BME-SBT/ESP32_CAN_V2/README.md

# ESP32_CAN_V2
New version of the ESP32-C6_CANboard repo
(Upgraded version of the ESP32_CAN_V1)
