BME-SBT/ESP32_CAN_V2/documentation/content/alkatreszlista.tex

\begin{landscape}
	\section{Alkatrész rendelési lista}
	\begin{center}
		\begin{longtable}{@{} p{6cm} p{5cm} p{10cm} p{2cm} @{}}
			\caption{CAN\_V1 alkatrészlista}\\
			\toprule
			Mfr. No & Manufacturer & Description & Order Qty. \\
			\midrule
			\endfirsthead
			
			\multicolumn{4}{c}{\textit{Folytatás az előző oldalról}}\\
			\toprule
			Mfr. No & Manufacturer & Description & Order Qty. \\
			\midrule
			\endhead
			
			\midrule
			\multicolumn{4}{r}{\textit{Folytatás a következő oldalon}}\\
			\endfoot
			
			\bottomrule
			\endlastfoot
			
			CL10B104KA8NFNC & Samsung Electro-Mechanics & Multilayer Ceramic Capacitors MLCC - SMD/SMT 100nF+/-10\% 25V X7R 0603 & 120 \\
			MBASG168AB7105KTNA01 & TAIYO YUDEN & Multilayer Ceramic Capacitors MLCC - SMD/SMT 35V 1uF X7R 0603 10\% & 15 \\
			06035C202JAT2A & KYOCERA AVX & Multilayer Ceramic Capacitors MLCC - SMD/SMT 50V 2000pF X7R 0603 5\% & 15 \\
			CL10B102KB85PNC & Samsung Electro-Mechanics & Multilayer Ceramic Capacitors MLCC - SMD/SMT 1nF+/-10\% 50V X7R 0603 & 15 \\
			EMK212BB7106KG-T & TAIYO YUDEN & Multilayer Ceramic Capacitors MLCC - SMD/SMT 16V 10uF X7R 0805 10\% & 60 \\
			CL21A226MAYNNNE & Samsung Electro-Mechanics & Multilayer Ceramic Capacitors MLCC - SMD/SMT 22uF+/-20\% 25V X5R 0805 & 50 \\
			CL21B225KPFNNNG & Samsung Electro-Mechanics & Multilayer Ceramic Capacitors MLCC - SMD/SMT 2.2uF+/-10\% 10V X7R 0805 & 15 \\
			CL10C470JC8NNNC & Samsung Electro-Mechanics & Multilayer Ceramic Capacitors MLCC - SMD/SMT 47pF+/-5\% 100V C0G 0603 & 40 \\
			AMK316ABJ107ML-T & TAIYO YUDEN & Multilayer Ceramic Capacitors MLCC - SMD/SMT 100uF X5R 1206 20\% & 15 \\
			WR06X1003FTL & Walsin & Thick Film Resistors - SMD 100K ohms 1\% 0603 & 40 \\
			CRCW060310K0JNEA & Vishay & Thick Film Resistors - SMD 1/8 Watt 10Kohms 5\% & 30 \\
			AC0603JR-07120RL & YAGEO & Thick Film Resistors - SMD 120 Ohms 1/10 W 75 V 5\% 0603 AEC-Q200 & 30 \\
			RC0603FR-101KL & YAGEO & Thick Film Resistors - SMD General Purpose Chip Resistor 0603, 1kOhms, 1\%, 1/10W & 30 \\
			CR0603-FX-5101ELF & Bourns & Thick Film Resistors - SMD 5.1K ohm 1\% & 30 \\
			RC0603FR-133K3L & YAGEO & Thick Film Resistors - SMD General Purpose Chip Resistor 0603, 3.3kOhms, 1\%, 1/10W & 15 \\
			CR0603-FX-3240ELF & Bourns & Thick Film Resistors - SMD 324 ohm 1\% & 15 \\
			CR0603-FX-3162ELF & Bourns & Thick Film Resistors - SMD 31.6K ohm 1\% & 15 \\
			RC0603JR-13470RL & YAGEO & Thick Film Resistors - SMD General Purpose Chip Resistor 0603, 470Ohms, 5\%, 1/10W & 15 \\
			RC0603FR-0764K9P & YAGEO & Thick Film Resistors - SMD General Purpose Chip Resistor 0603, 64.9kOhms, 1\%, 1/10W & 15 \\
			CR0603-FX-3092ELF & Bourns & Thick Film Resistors - SMD 30.9KOHM 1/10WATT 1\% & 15 \\
			RC0603FR-07154KL & YAGEO & Thick Film Resistors - SMD General Purpose Chip Resistor 0603, 154kOhms, 1\%, 1/10W & 15 \\
			AC0603FR-0713K7L & YAGEO & Thick Film Resistors - SMD 13.7 kOhms 1/10 W 75 V 1\% 0603 AEC-Q200 & 15 \\
			USBLC6-2SC6 & STMicroelectronics & ESD Protection Diodes / TVS Diodes ESD Protection Low Cap & 15 \\
			150060YS83000 & Wurth Elektronik & Single Colour LEDs WL-SMCW SMT 0603 Dome Yellow Typ 650mcd 2V & 15 \\
			150060AS83000 & Wurth Elektronik & Single Colour LEDs WL-SMCW SMT 0603 Dome Amber Typ 500mcd 2V & 15 \\
			150060RS83000 & Wurth Elektronik & Single Colour LEDs WL-SMCW SMT 0603 Dome Red Typ 1800mcd 2V & 15 \\
			150060VS83000 & Wurth Elektronik & Single Colour LEDs WL-SMCW SMT 0603 Dome Bright Green Typ 300mcd 2V & 15 \\
			150060BS83000 & Wurth Elektronik & Single Colour LEDs WL-SMCW SMT 0603 Dome Blue Typ 1500mcd 3.2V & 15 \\
			10129381-908002BLF & Amphenol & Headers \& Wire Housings ECONOSTIK HEADER DR VT TH 2X4 & 12 \\
			10129381-924003BLF & Amphenol & Headers \& Wire Housings ECONOSTIK HEADER DR VT TH 2X12 & 12 \\
			10129381-906003BLF & Amphenol & Headers \& Wire Housings ECONOSTIK HEADER DR VT TH 2X3 & 12 \\
			TBC05-03-1-G-G & GCT & Fixed Terminal Blocks 3w, 2.54mm Pitch Term-Block, Side Entry, TH, Rising Clamp & 2 \\
			TPS25921ADR & Texas Instruments & Hot Swap Voltage Controllers eFuse Mux OR A TPS25921AD & 11 \\
			LMR51430YDDCR & Texas Instruments & Switching Voltage Regulators SIMPLE SWITCHER 4.5-V to 36-V 3-A & 11 \\
			AP62250WU-7 & Diodes Incorporated & Switching Voltage Regulators DCDC Conv HV Buck TSOT26 3K & 12 \\
			1N5819HW-7-F & Diodes Incorporated & Schottky Diodes \& Rectifiers Vr/40V Io/1A T/R & 11 \\
			USB4105-GF-A & GCT & USB Connectors USB Type C,2.0, Rec,SMT, 0.95mmTH Shell Stakes,G/F,RA,Top Mnt,T\&R & 15 \\
			TBC05-04-1-G-G & GCT & Fixed Terminal Blocks 4w, 2.54mm Pitch Term-Block, Side Entry, TH, Rising Clamp & 2 \\
			TBC05-06-1-G-G & GCT & Fixed Terminal Blocks 6w, 2.54mm Pitch Term-Block, Side Entry, TH, Rising Clamp & 8 \\
			71966-308LF & Amphenol & Headers \& Wire Housings DUBOX RCP DR TMT VERT-POLARIZED & 2 \\
			76314-203LF & Amphenol & Headers \& Wire Housings PV & 2 \\
			76314-204LF & Amphenol & Headers \& Wire Housings PV & 2 \\
			PTSAHT120624V050 & Eaton & Resettable Fuses - PPTC PTSAHT1206 0.5A, 24V & 85 \\
			TS02-66-70-BK-260-SCR-D & Same Sky & Tactile Switches 6 x 6 mm, 7 mm Act Height, 260 gf, Black, Short Crimped, Through Hole, SPST, & 25 \\
			SMAJ30A & Littelfuse & ESD Protection Diodes / TVS Diodes 400W 30V 5\% Uni-Directional & 25 \\
			NUP2105L & Diotec Semiconductor & ESD Protection Diodes / TVS Diodes ESD Diode, SOT-23, 150C, 350W, Unidir & 15 \\
			R05CTE05S-R & RECOM & DC/DC Converters - SMD 1W 4.5-5.5Vin 5.0Vout 200mA Reel & 11 \\
			ISO6721FQDWVRQ1 & Texas Instruments & Digital Isolators Automotive general-purpose dual-channel & 11 \\
			TCAN1051HGDR & Texas Instruments & CAN Interface IC Fault Protected CAN Transceiver & 11 \\
			ESP32-C6-WROOM-1-N4 & Espressif & Multiprotocol Modules 4 MB (Quad SPI), 32-bit RISC-V Embedded Module & 11 \\
			ULN2003ADR & Texas Instruments & Darlington Transistors ULN2003 & 11 \\
			74HC595D & Toshiba & Counter Shift Registers CMOS LOGIC IC SERIES & 11 \\
			SMAJ58CA & Littelfuse & ESD Protection Diodes / TVS Diodes 400W 58V 5\% Bi-Directional & 15 \\
			AMPLA5030S-6R8MT & ABRACON & Power Inductors - SMD & 11 \\
			LCENA2520MKT2R2M0NK & TAIYO YUDEN & Power Inductors - SMD 2.2 UH 20\% & 11 \\
			
		\end{longtable}
	\end{center}
\end{landscape}
