BME-SBT/ESP32_CAN_V2/documentation/includes/cimoldal.tex

%\hypersetup{pageanchor=false}

%--------------------------------------------------------------------------------------
%	Címoldal [Title page]
%--------------------------------------------------------------------------------------
\begin{titlepage}
	\begin{center}
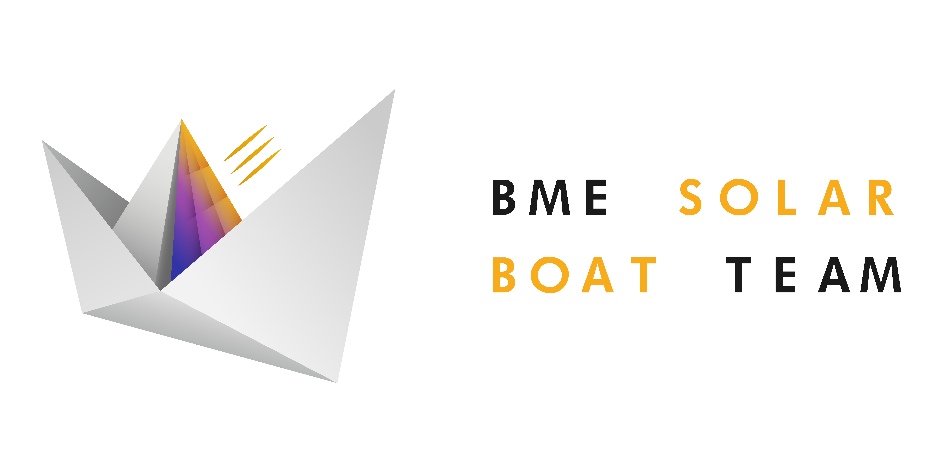
[picture p7: documentation/includes/BME-SolarBoat-logo.png]
		\\
		
		\vspace{4cm}
		
		{\Huge \MakeUppercase{\title}}\\
		\vspace{0.8cm}
		{\LARGE \subtitle}
		
		%\vspace{2cm}
		\vfill
		
		{\large \textit{
			\iflanguage{hungarian}{
				%Szerző:
			}{
				Author:
			}
		}}
		%\vspace{0.3cm}
		
		{\large
			\authorA
			
			\authorB
			
			\authorC
			
			\authorD
		}
		
		\vfill
		{\large Budapest , \today}
	\end{center}
\end{titlepage}
