BME-SBT/ESP32_CAN_V2/hardware/MessageListReport.html

Altium customize

# Message List

Date: | | 19/02/2026
Time: | | 23:58:55
Elapsed Time: | | 00:00:00

Class | Document | Source | Message | Time | Date | No.
[Warning] | ESP32_CAN_V2-can.SchDoc | Compiler | Footprint of component Component SJ1 Solderj Jumper cannot be found | 23:58:21 | 19/02/2026 | 1
[Warning] | ESP32_CAN_V2-main.SchDoc | Compiler | Nets Wire GND_CAN has multiple names (Net Label GND_CAN (6), Sheet Entry U_ESP32_CAN_V2-can-CAN_GND(Passive)) | 23:58:21 | 19/02/2026 | 2
[Info] | ESP32_CAN_V2.PrjPcb | Compiler | Compile successful, no errors found. | 23:58:21 | 19/02/2026 | 3

Back to top
