BME-SBT/ESP32_CAN_V2/documentation/pinouts.pdf

MCU ports: | Note:
GPIO_0 GPIO_1 GPIO_2 GPIO_3 GPIO_4 GPIO_5 GPIO_6 GPIO_7 GPIO_8 GPIO_9 GPIO_10 GPIO_11 GPIO_12 GPIO_13 GPIO_14 GPIO_15 | IO1 IO0 IO7 IO6 IO5 IO4 IO16 IO9 General Purpose IO18 Input/Ouput ports IO19 IO20 IO21 IO22 IO23 IO15 IO17
COM OUT_0 OUT_1 OUT_2 OUT_3 OUT_4 OUT_5 OUT_6 | This must be connected with the supply voltage of the driven devices. Shiftreg: IO8, IO10, IO11 Darlington Transistor Array with 500mA collector current capability
BUS_0 BUS_1 BUS_2 BUS_3 BUS_4 BUS_5 BUS_6 BUS_7 | Extra wires in the CAT6 cable to be able to Does not connects to connect boards with a the mcu. redundant line it it is needed.
