BME-SBT/ESP32_CAN_V2/documentation/pinouts.xlsx

 | MCU ports: | Note:
GPIO_0 | IO1 | General Purpose Input/Ouput ports
GPIO_1 | IO0
GPIO_2 | IO7
GPIO_3 | IO6
GPIO_4 | IO5
GPIO_5 | IO4
GPIO_6 | IO16
GPIO_7 | IO9
GPIO_8 | IO18
GPIO_9 | IO19
GPIO_10 | IO20
GPIO_11 | IO21
GPIO_12 | IO22
GPIO_13 | IO23
GPIO_14 | IO15
GPIO_15 | IO17
COM | Shiftreg: IO8, IO10, IO11 | This must be connected with the supply voltage of the driven devices.
OUT_0 |  | Darlington Transistor Array with 500mA collector current capability
OUT_1
OUT_2
OUT_3
OUT_4
OUT_5
OUT_6
BUS_0 | Does not connects to the mcu. | Extra wires in the CAT6 cable to be able to connect boards with a redundant line it it is needed.
BUS_1
BUS_2
BUS_3
BUS_4
BUS_5
BUS_6
BUS_7
