BME-SBT/ESP32_CAN_V2/documentation/ppt/CAN Hardware.pptx

## CAN Hardware

Fináczy Balázs

## CAN-bus

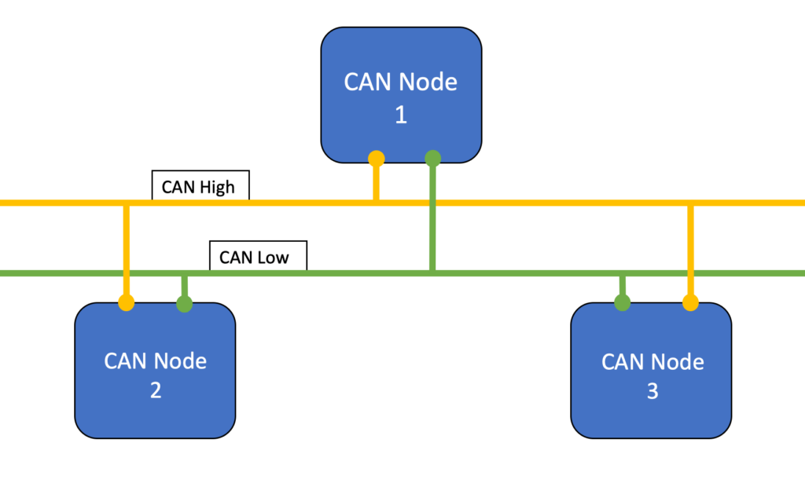
[picture p10: figure]

## Rendszerterv

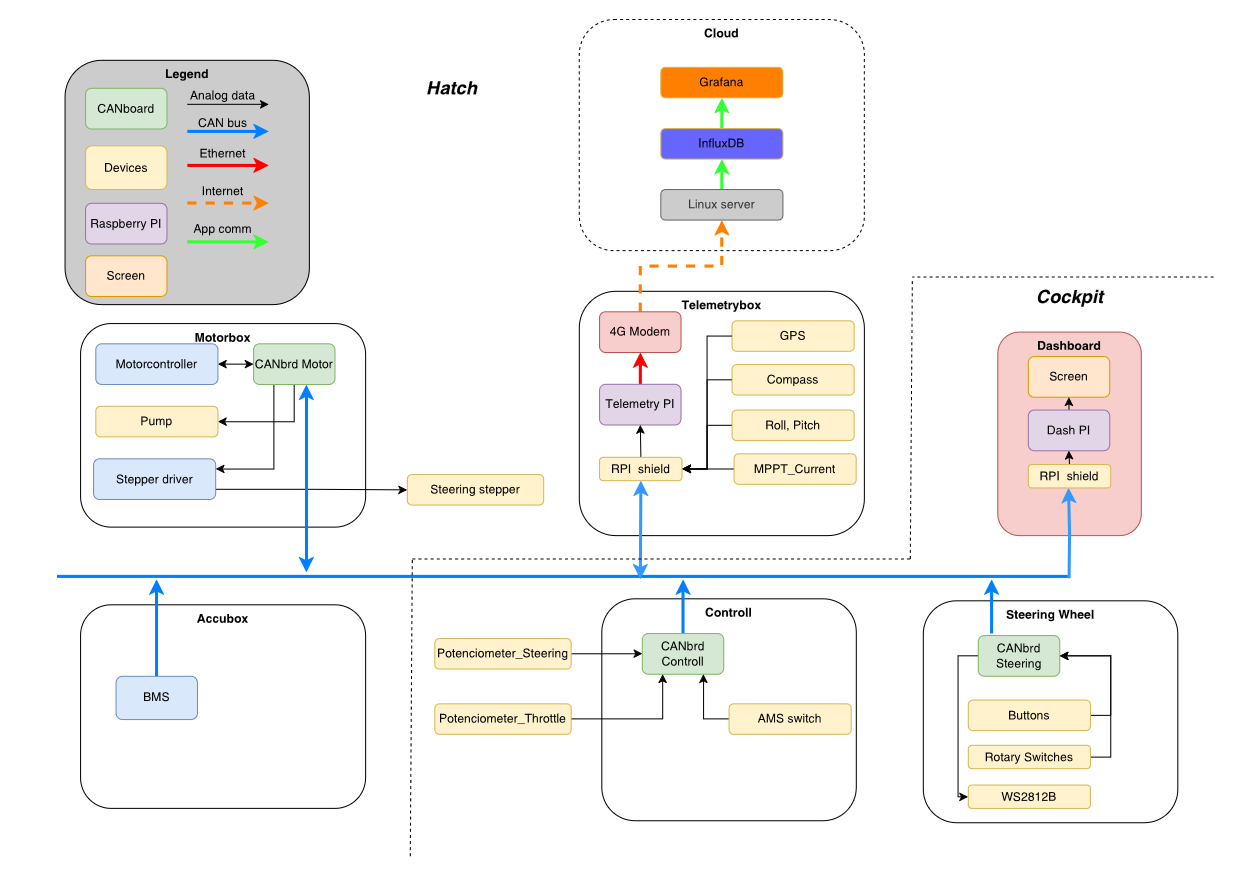
[picture p11: figure]

## Slide 4

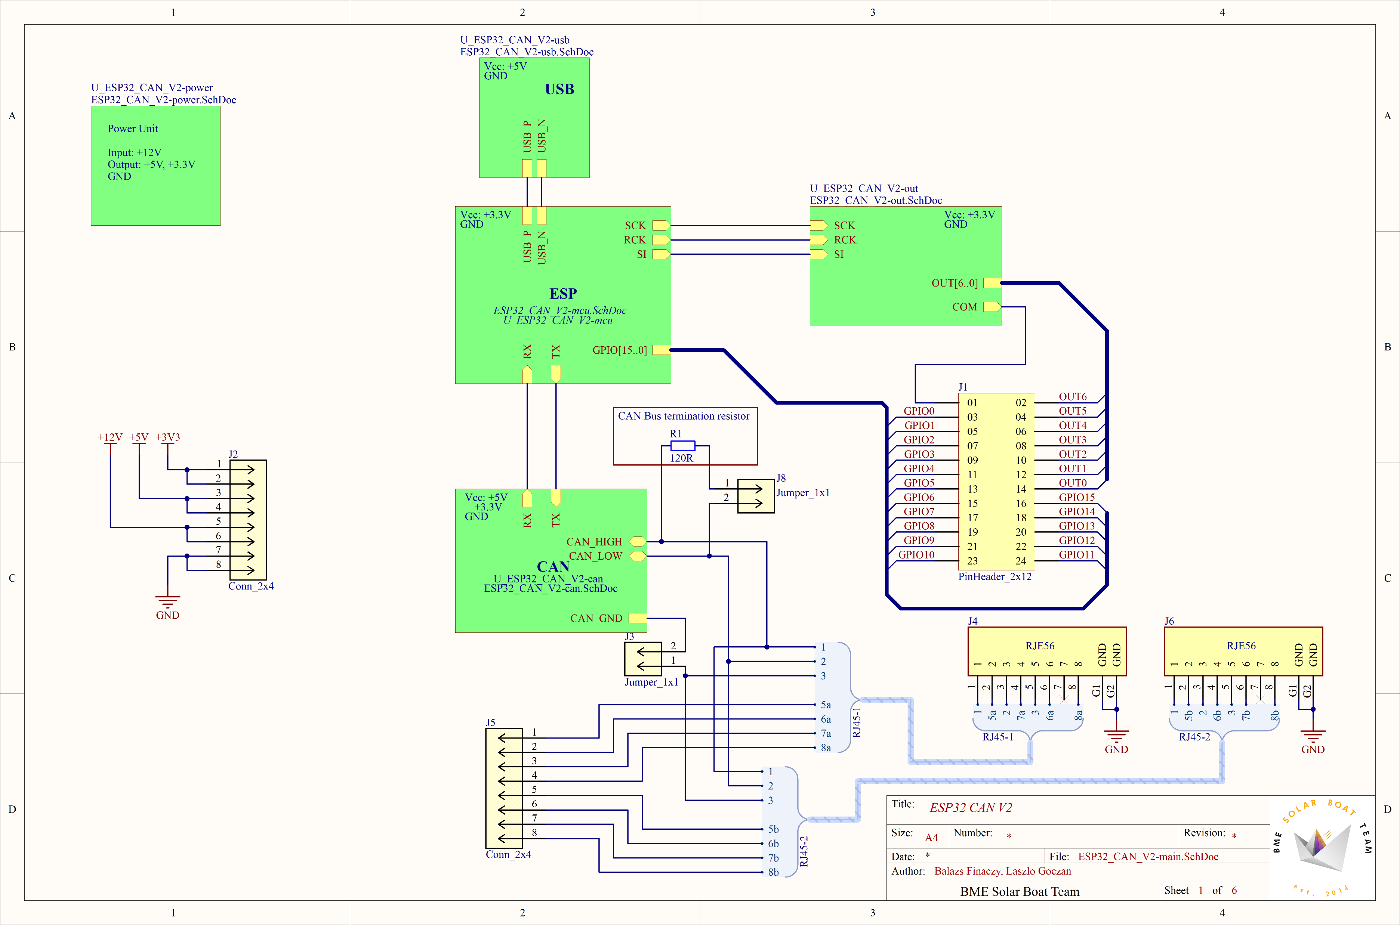
[picture p12: figure]

## Slide 5

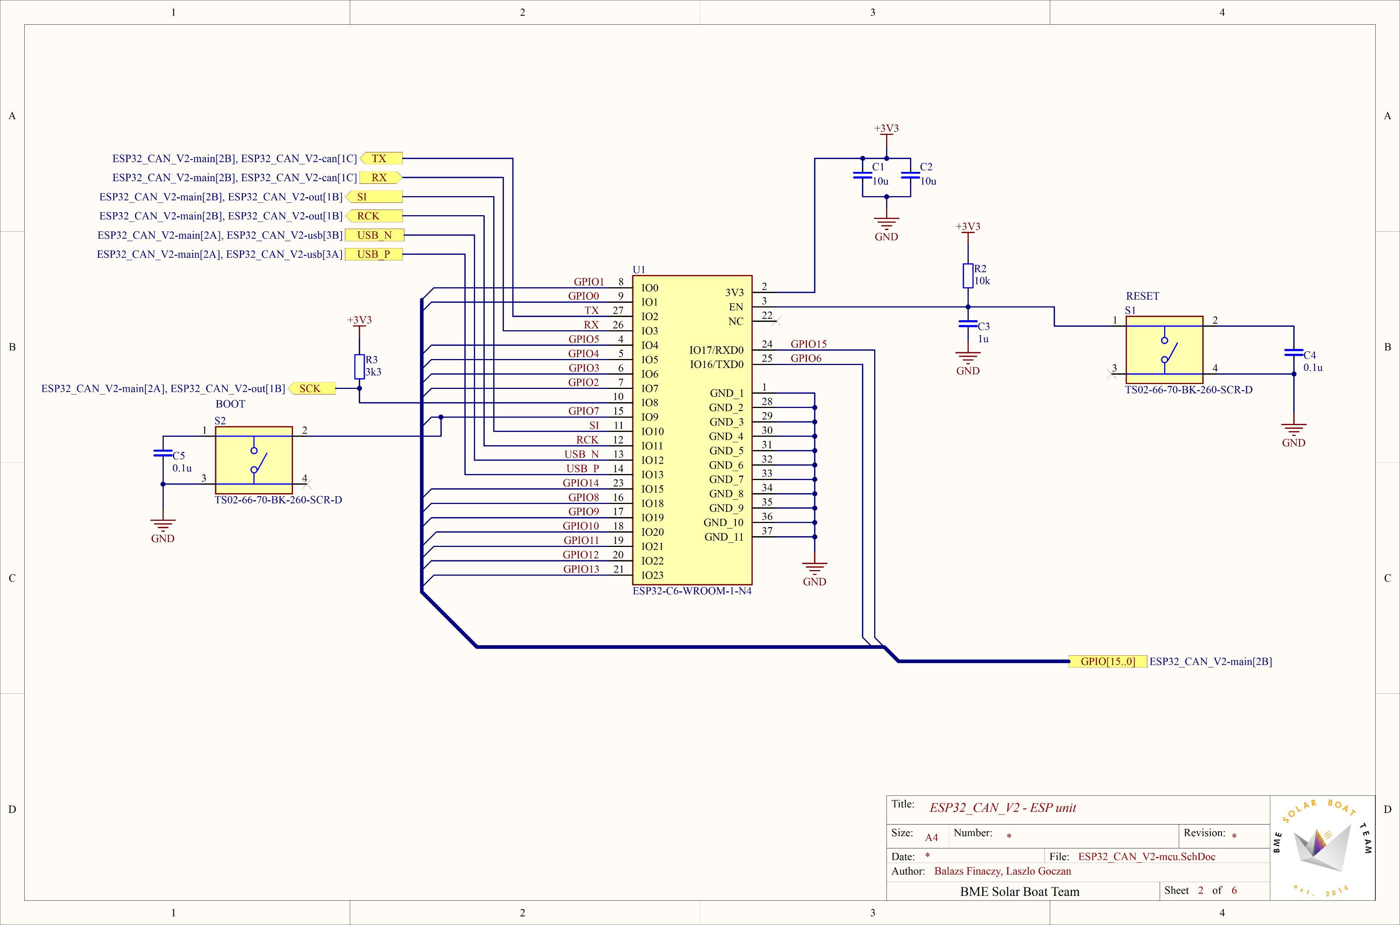
[picture p13: figure]

## Slide 6

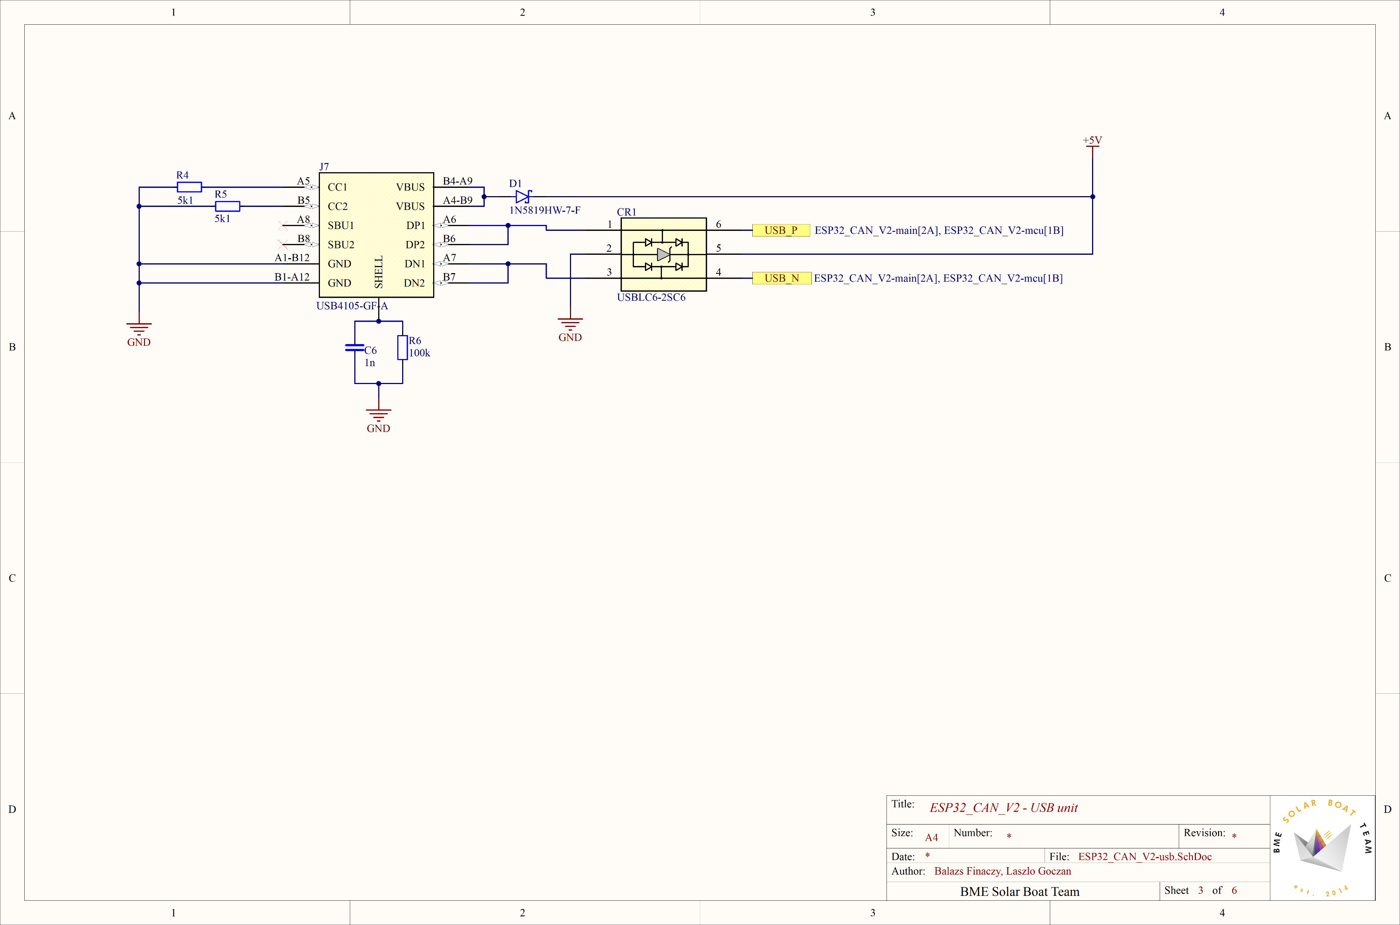
[picture p14: figure]

## Slide 7

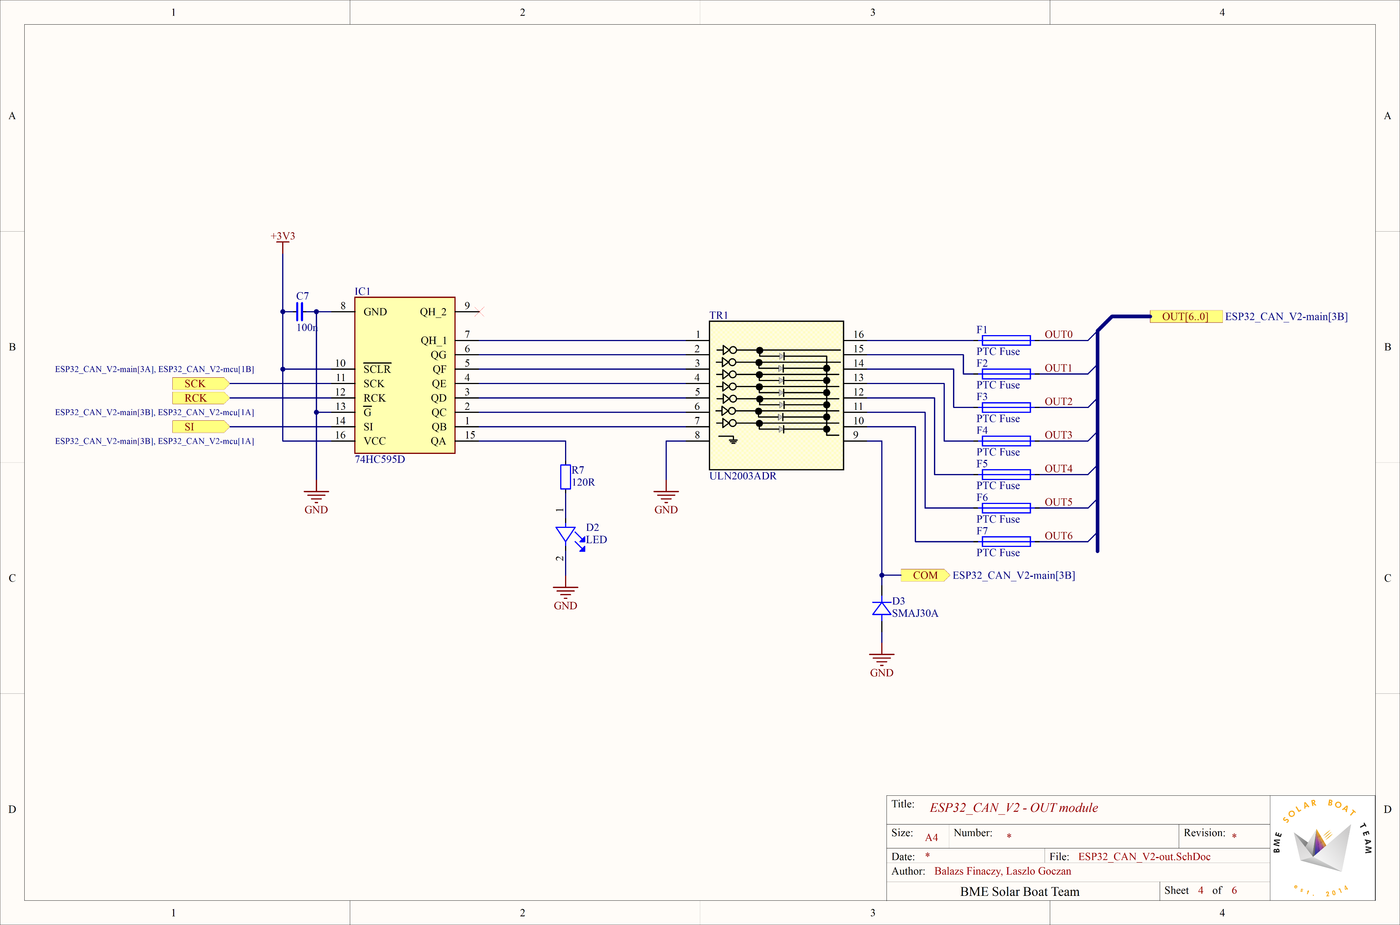
[picture p15: figure]

## Slide 8

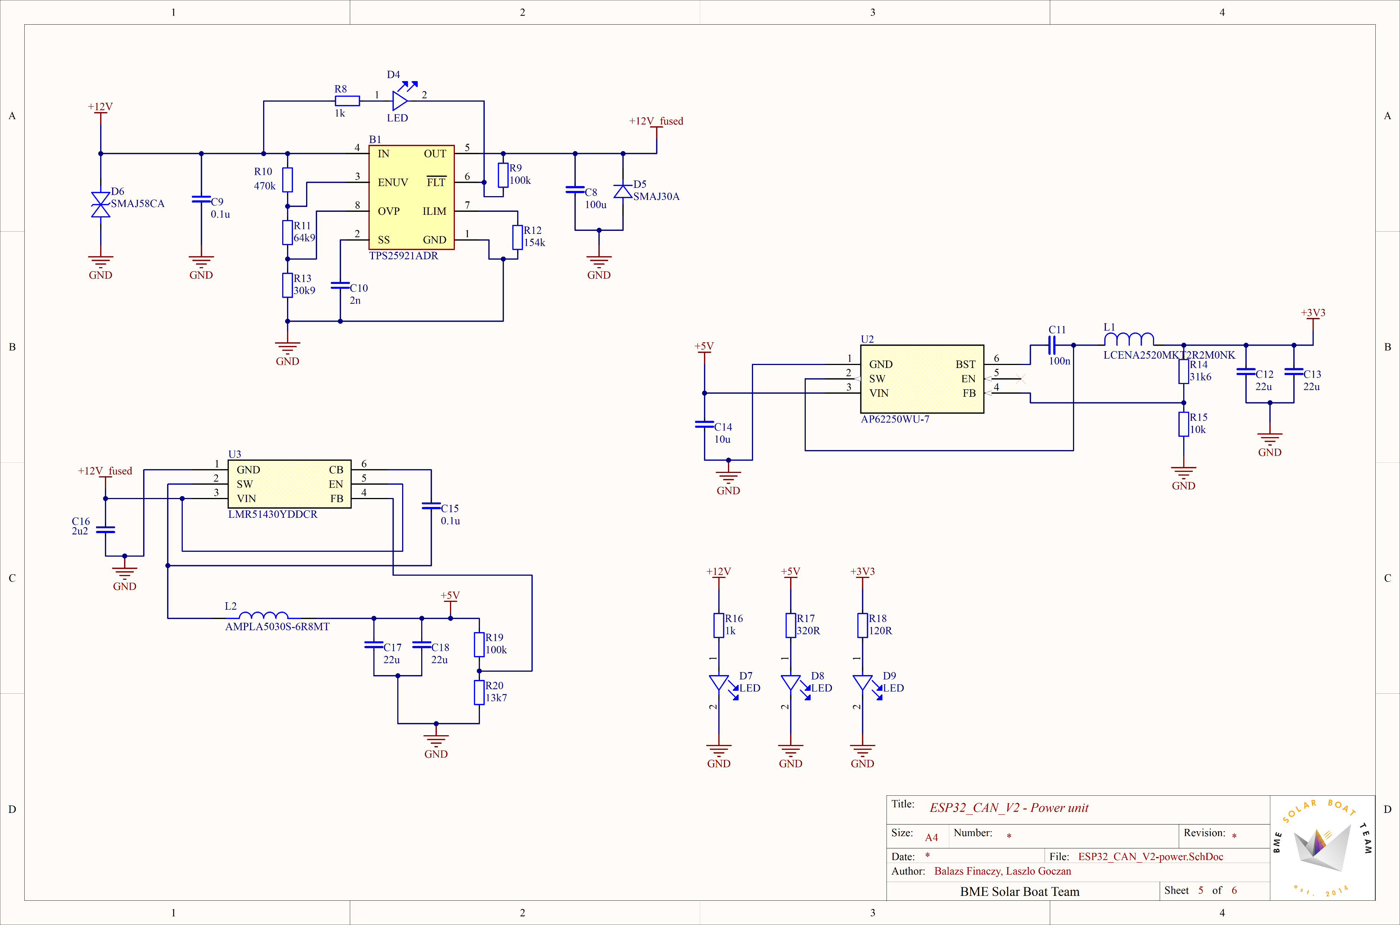
[picture p16: figure]

## Slide 9


## Slide 10

## Slide 11

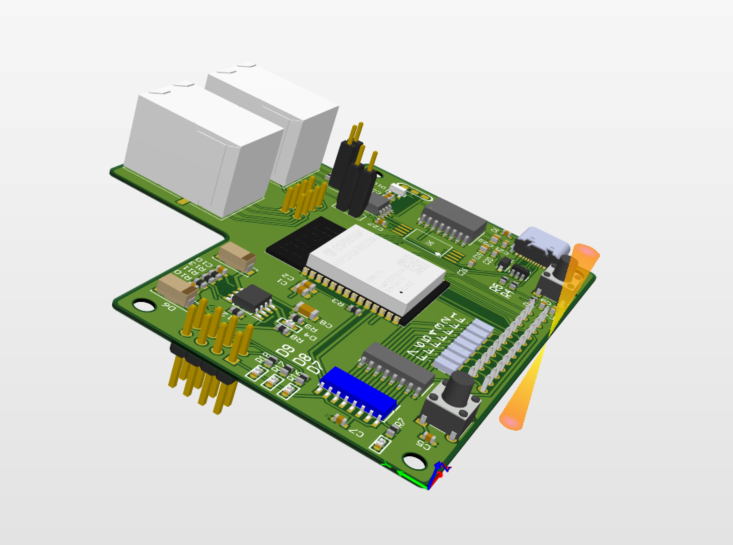
[picture p17: figure]

## Slide 12

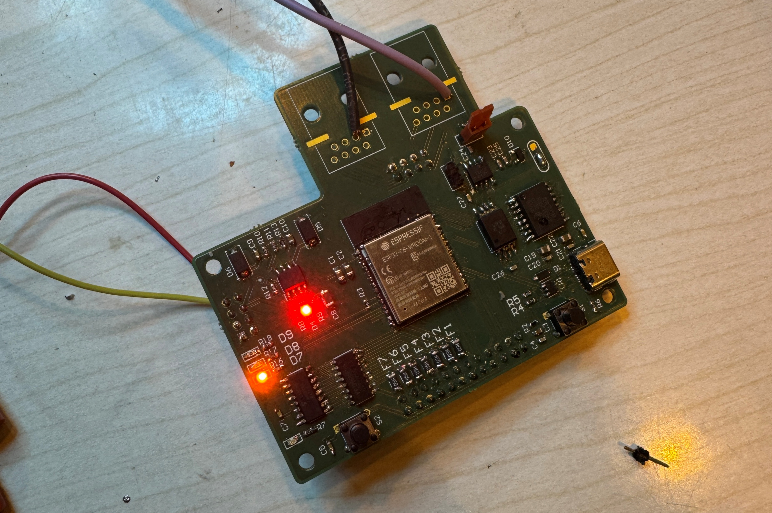
[picture p18: figure]

## Köszönöm a figyelmet!
