BME-SBT/ESP32_CAN_V2/hardware/board_outline_v2.dxf

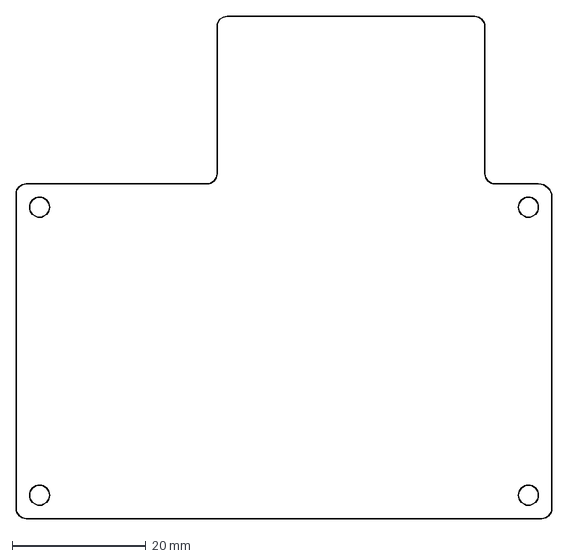
[picture p21: CAD file, 2026-06-18]
hardware/board_outline_v2.dxf
80.0 x 75.0 mm
