BME-SBT/ESP32_CAN_V2/hardware/ESP32_CAN_V2.pdf

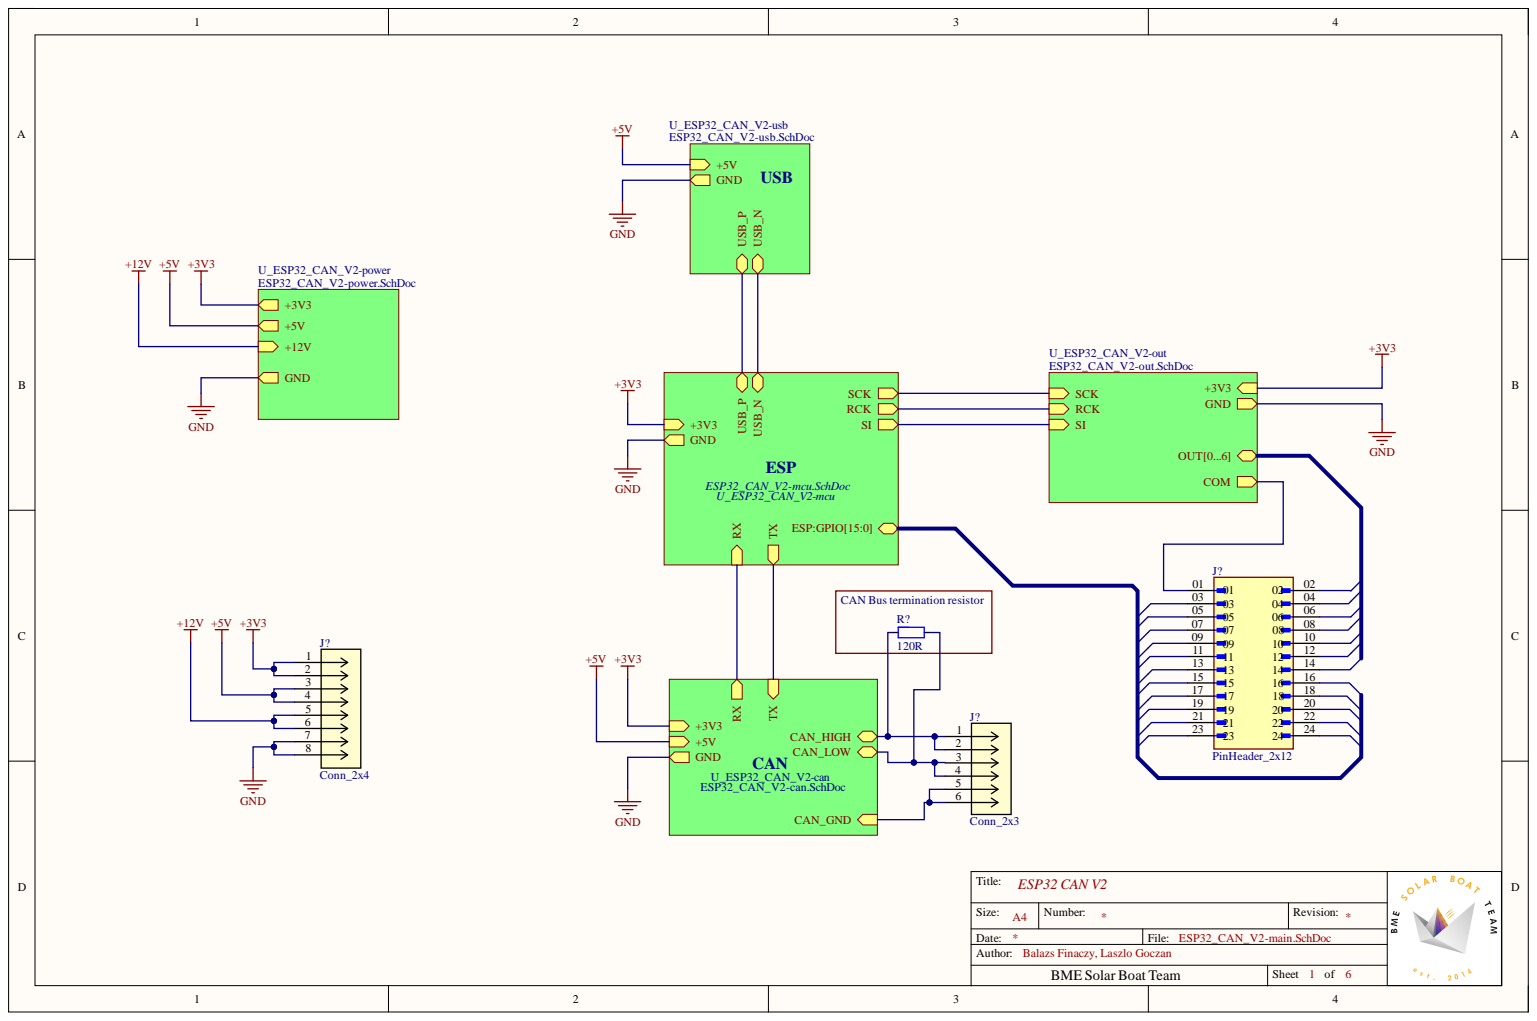
[picture p22: page 1]

T i t l e : ESP3 2 CAN V2

Size : A 4 | N umb er : * | Rev i s i o n : *

Dat e : * | Fi l e : ESP3 2 _CA N _ V 2-mai n . S c h D o c

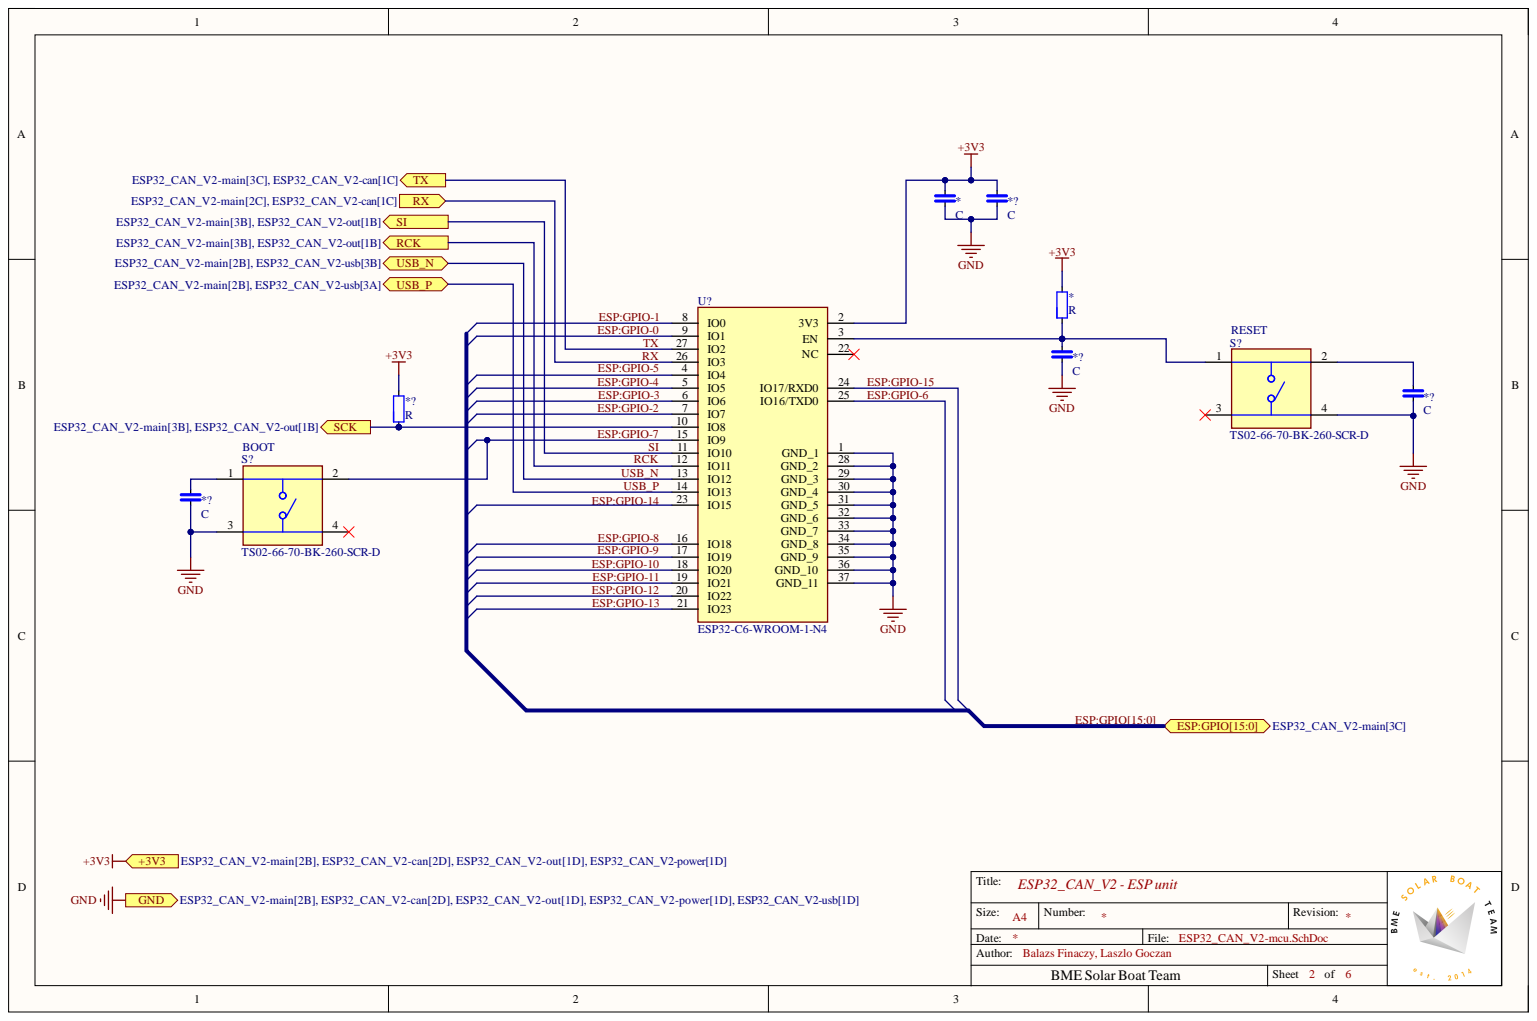
[picture p23: page 2]

ESP:GPIO-5 ESP:GPIO-4 ESP:GPIO-3 ESP:GPIO-2 ESP:GPIO-7 | IO4 4 IO5 5 IO6 6 IO7 7 IO8 10 IO9 15

Title: ESP32_CAN_V2 - ESPunit

Size: A4 | Number: * | Revision: *

Date: * | File: ESP32_CAN_V2-mcu.SchDoc

Balazs Finaczy, Laszlo Goczan
BME Solar Boat Team

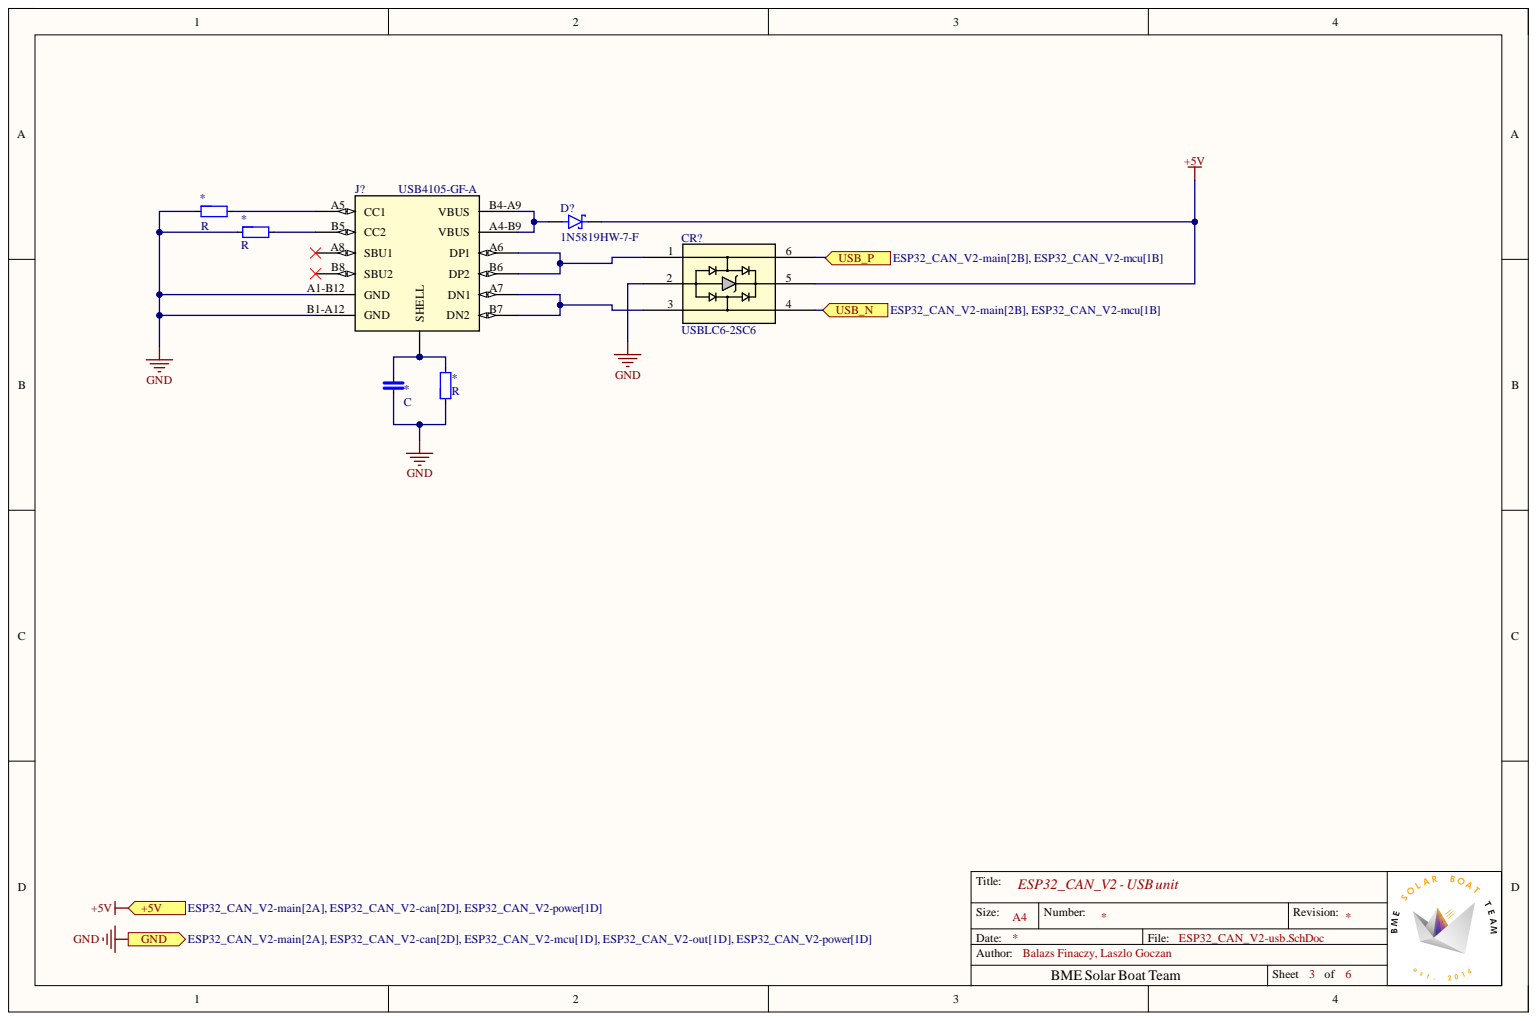
[picture p24: page 3]

Title: ESP32_CAN_V2 - USB unit

Size: A4 | Number: * | Revision: *

Date: * | File: ESP32_CAN_V2-usb.SchDoc

Balazs Finaczy, Laszlo Goczan

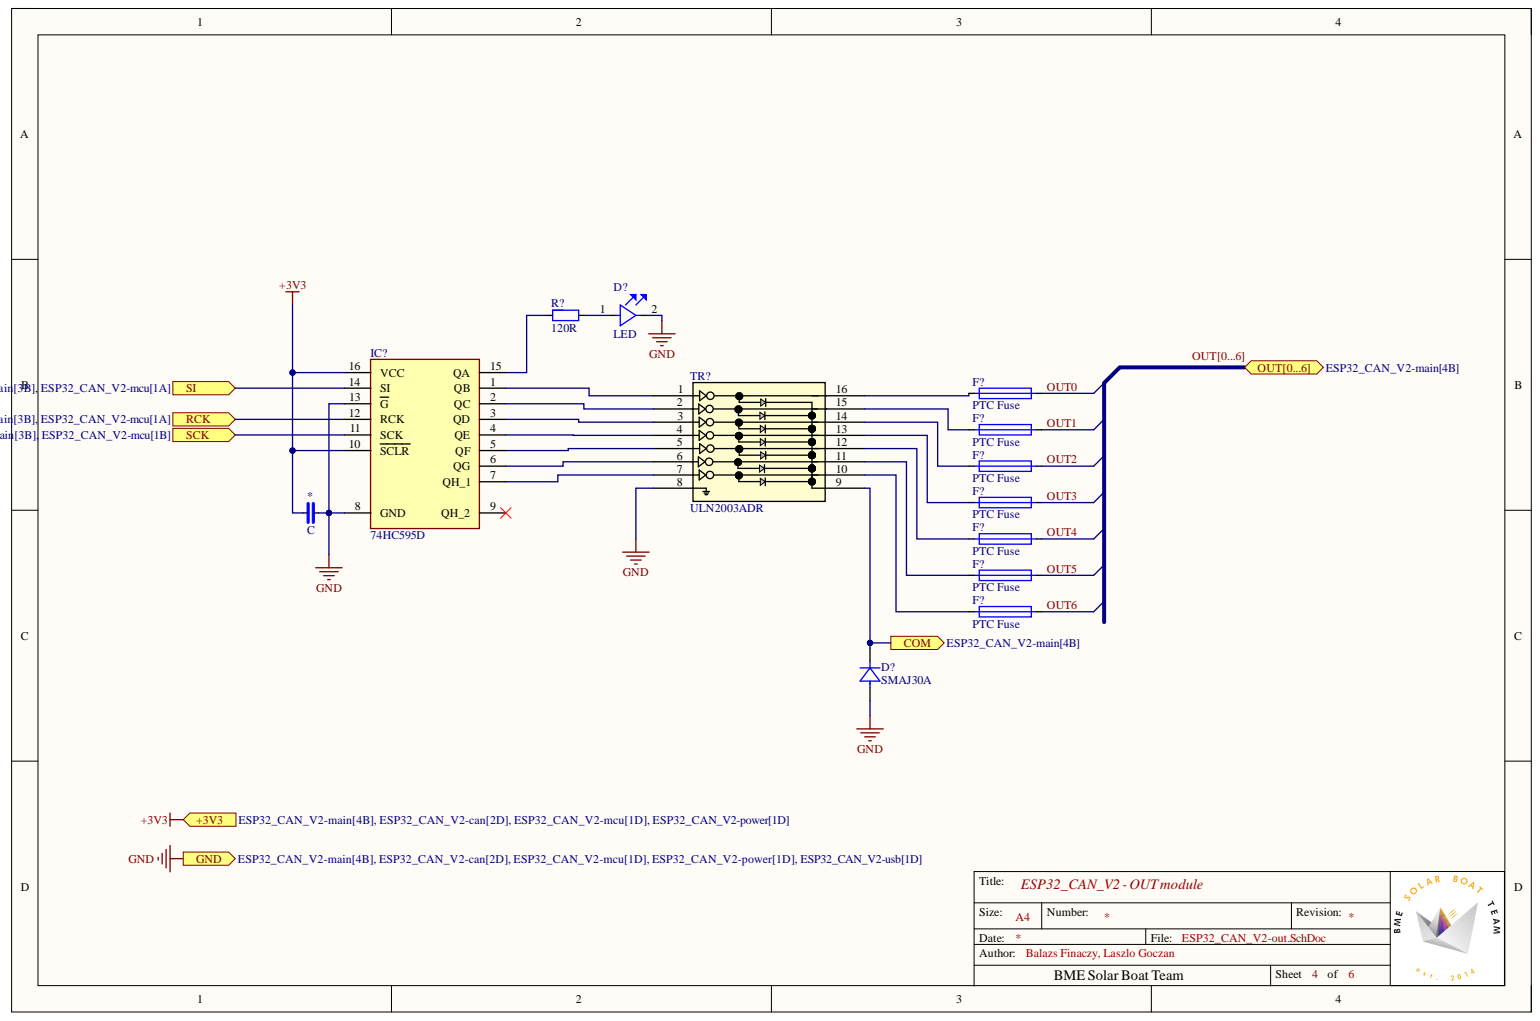
[picture p25: page 4]

Title: ESP32_CAN_V2 - OUTmodule

Size: A4 | Number: * | Revision: *

Date: * | File: ESP32_CAN_V2-out.SchDoc

Balazs Finaczy, Laszlo Goczan

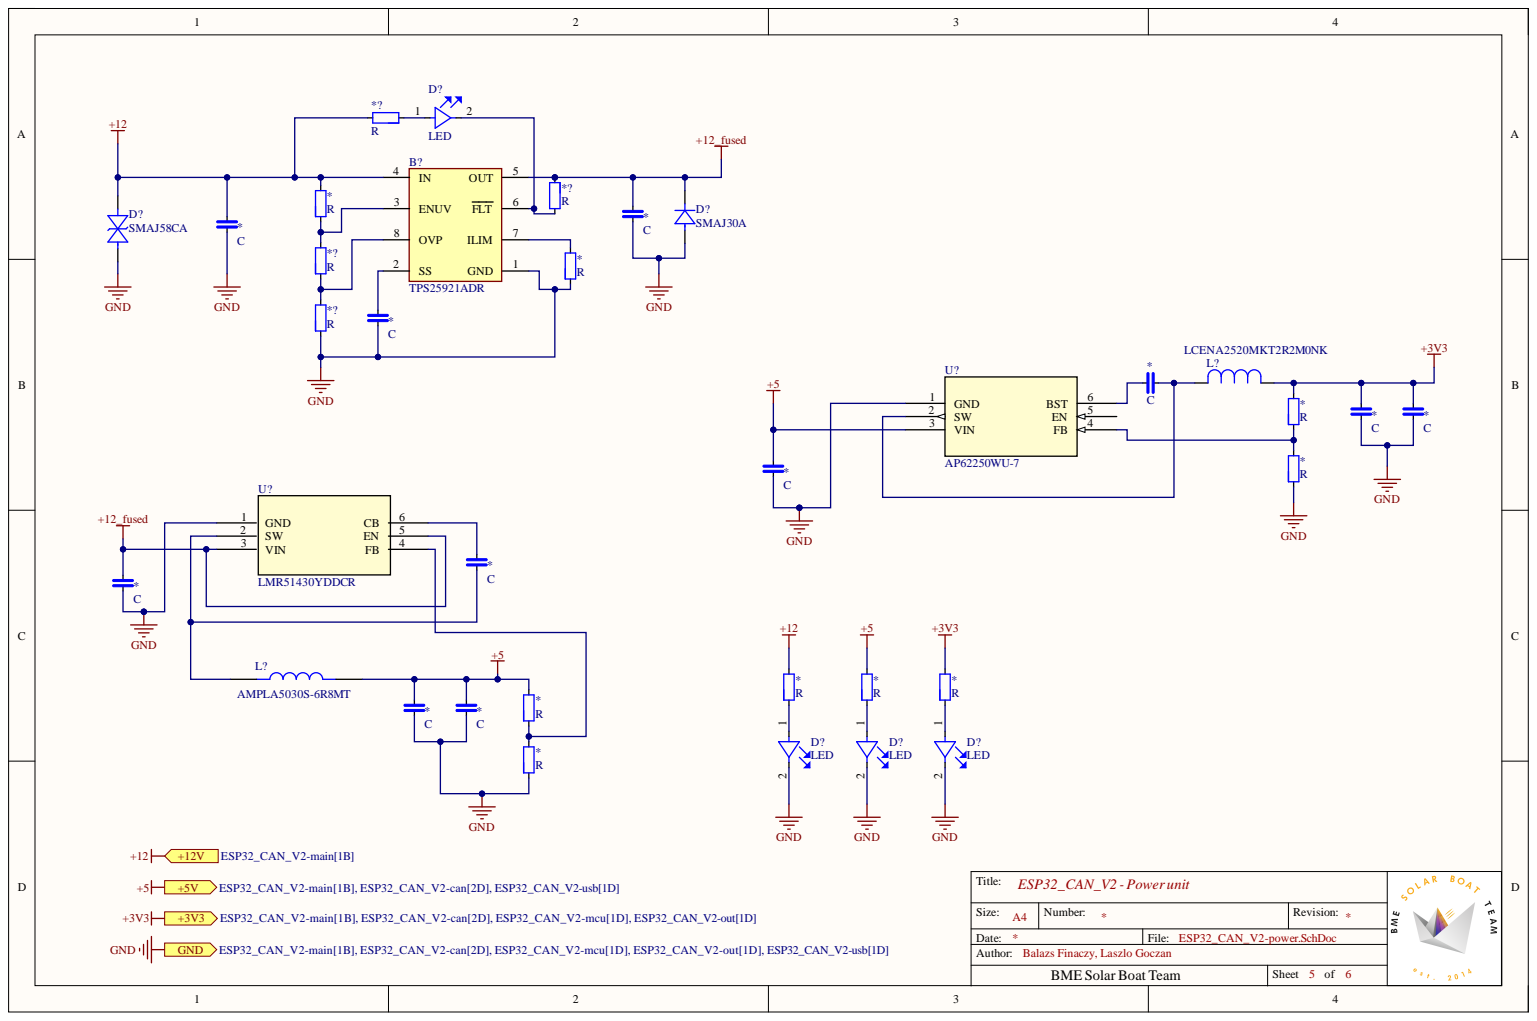
[picture p26: page 5]

O V P | O U T | 5 B? TPS25921ADR

8 | ILIM G N D | 1 SS

SW E N V IN | 4

T i t l e : ESP3 2 _CAN_V2 - Power u n i t

Size : A 4 | N umb er : * | Rev i s i o n : *

Dat e : * | Fi l e : ESP3 2 _CA N _ V 2-p o wer . S c h D o c

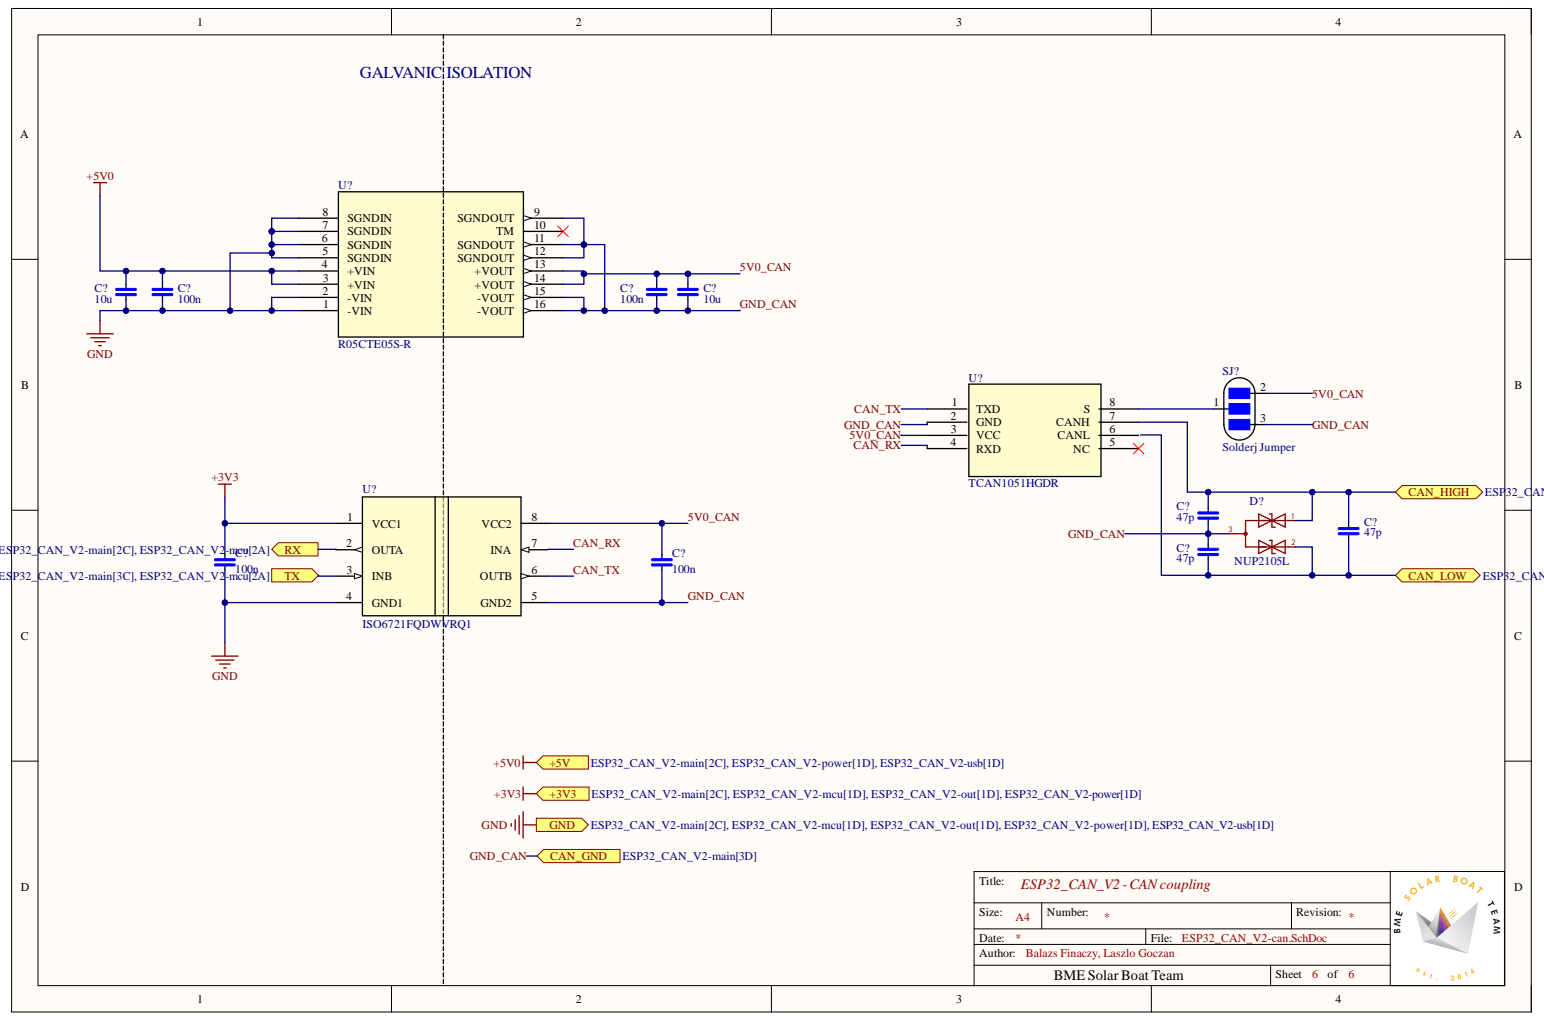
[picture p27: page 6]

Title: ESP32_CAN_V2 - CAN coupling

Size: A4 | Number: * | Revision: *

Date: * | File: ESP32_CAN_V2-can.SchDoc

Balazs Finaczy, Laszlo Goczan
