BME-SBT/ESP32_CAN_V2/ESP32_CAN_V2.pdf

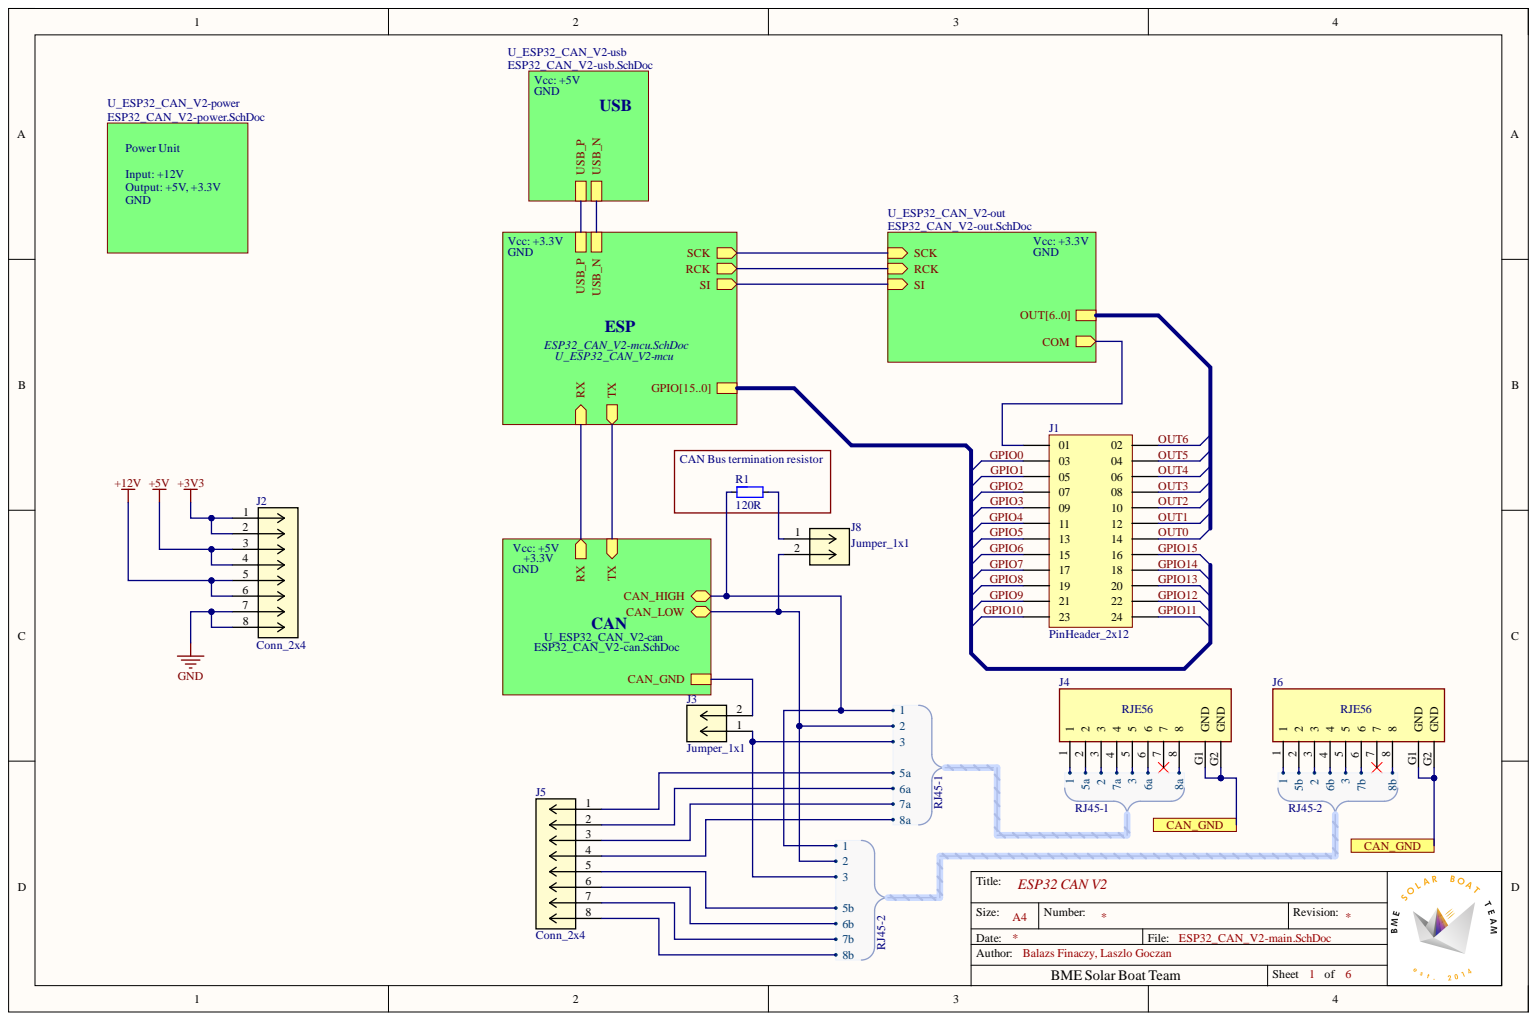
[picture p28: page 1]

T i t l e : ESP3 2 CAN V2

Size : A 4 | N umb er : * | Rev i s i o n : *

Dat e : * | Fi l e : ESP3 2 _CA N _ V 2-mai n . S c h D o c

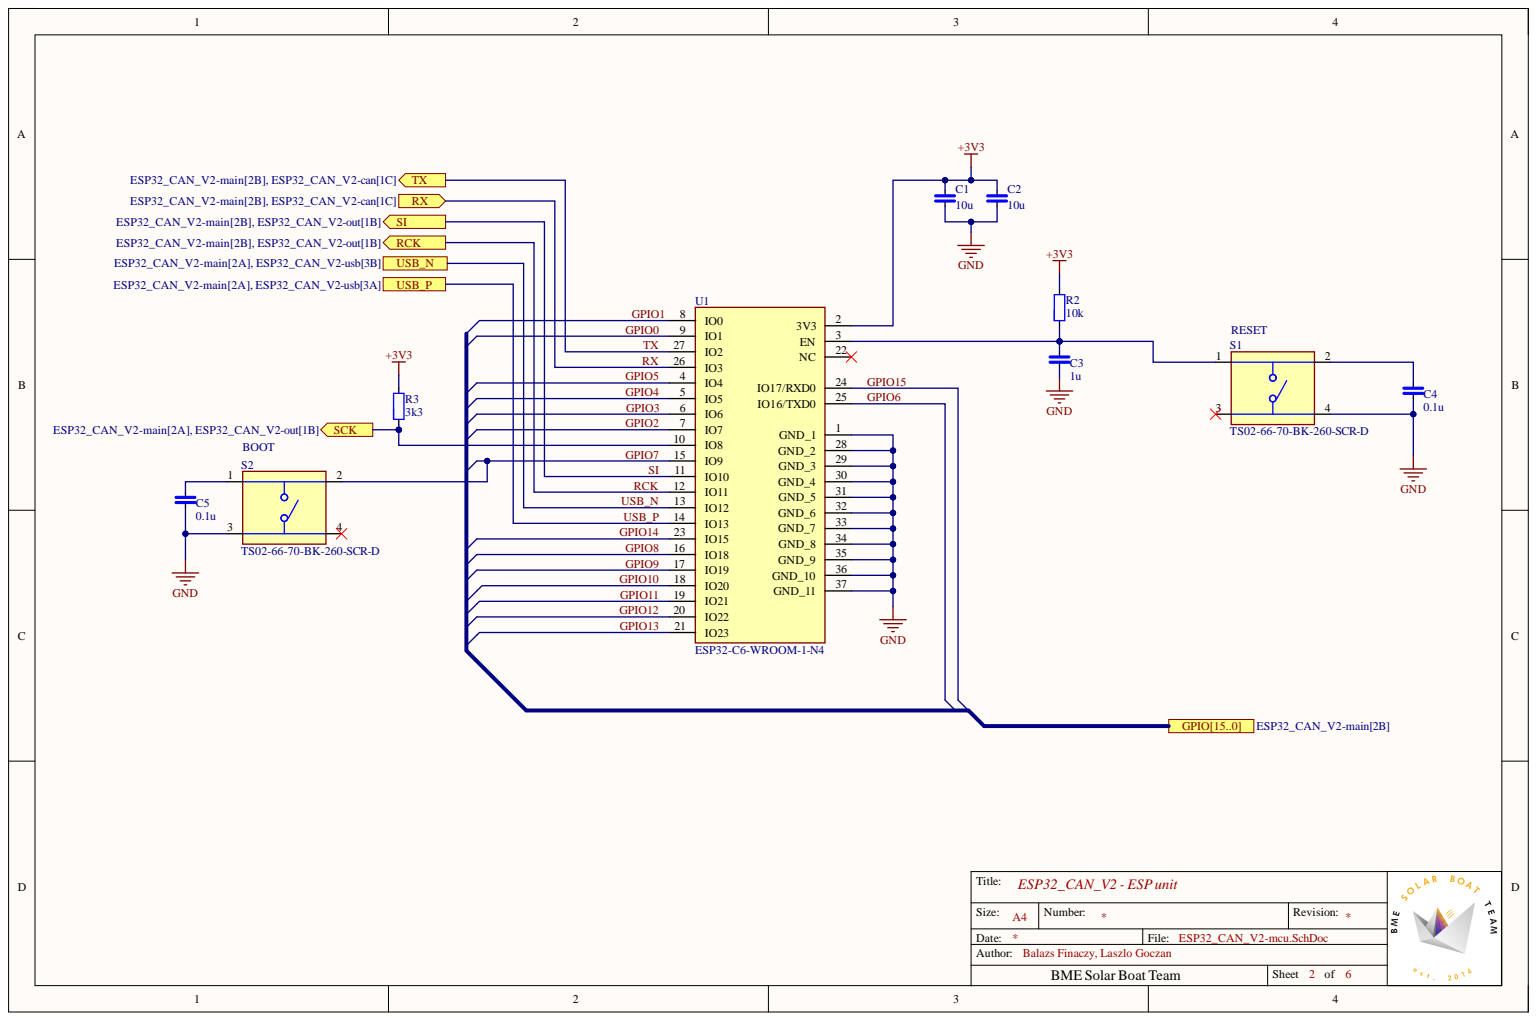
[picture p29: page 2]

2 5 | GPIO 6

2 8
2 9
3 0

GPIO 7 | 1 5
SI | 1 1
RCK | | 1 2
USB_ N | | 1 3
USB_ P | | 1 4

3 2
3 3
3 4
3 5
3 6
3 7

T i t l e : ESP3 2 _CAN_V2 - ESP u nit

Size : A 4 | N umb er : * | Rev i s i o n : *

Dat e : * | Fi l e : ESP3 2 _CA N _ V 2-mcu.S c h D o c

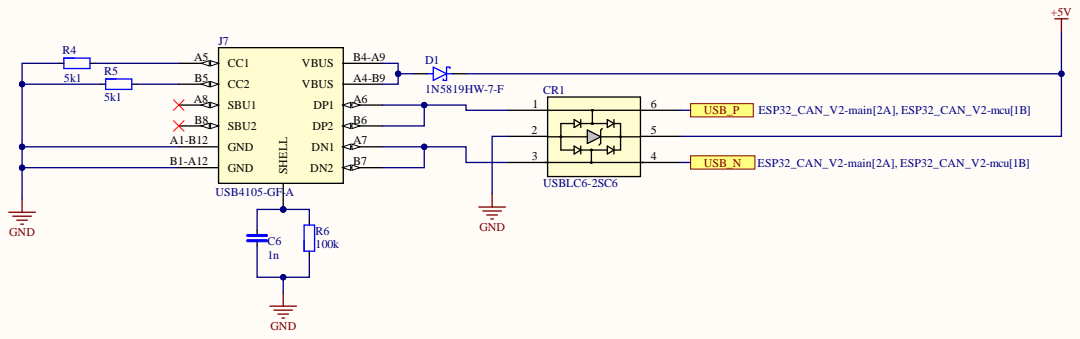
[picture p30: page 3]

T i t l e : ESP3 2 _CAN_V2 - USB u nit

Size : A 4 | N umb er : * | Rev i s i o n : *

Dat e : * | Fi l e : ESP3 2 _CA N _ V 2-u s b . S c h D o c

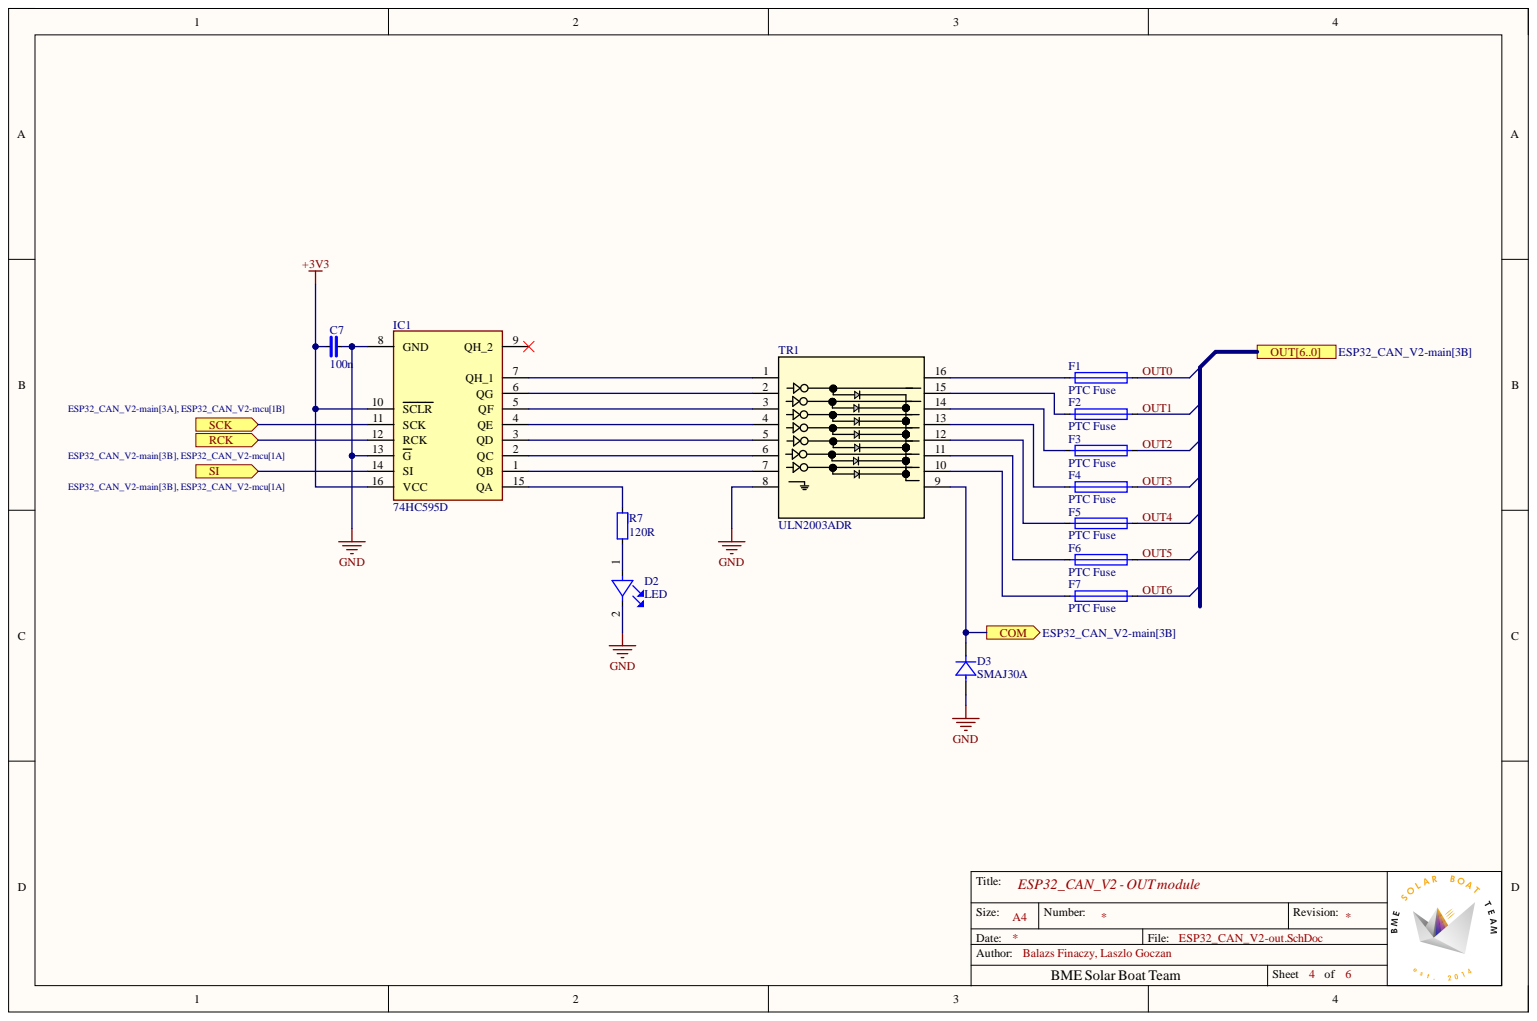
[picture p31: page 4]

T i t l e : ESP3 2 _CAN_V2 - OUTmo d u le

Size : A 4 | N umb er : * | Rev i s i o n : *

Dat e : * | Fi l e : ESP3 2 _CA N _ V 2-o u t . S c h D o c

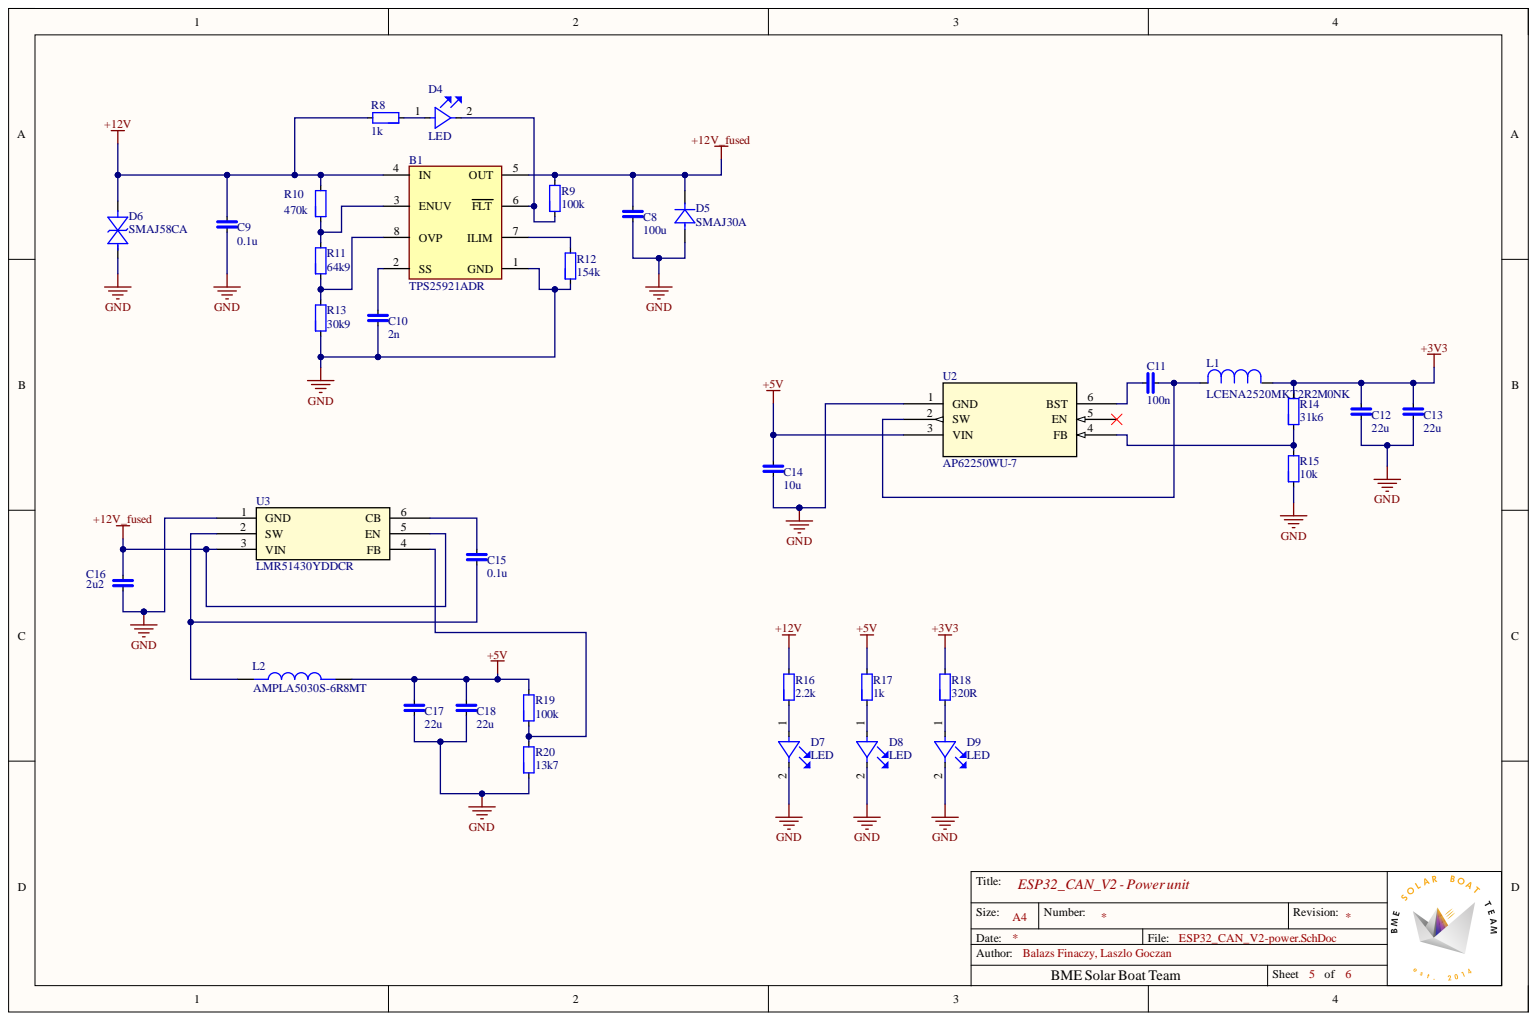
[picture p32: page 5]

O V P | O U T | 5 B1 TPS25921ADR

8 | ILIM G N D | 1 SS

V IN | 4

T i t l e : ESP3 2 _CAN_V2 - Power u n i t

Size : A 4 | N umb er : * | Rev i s i o n : *

Dat e : * | Fi l e : ESP3 2 _CA N _ V 2-p o wer . S c h D o c

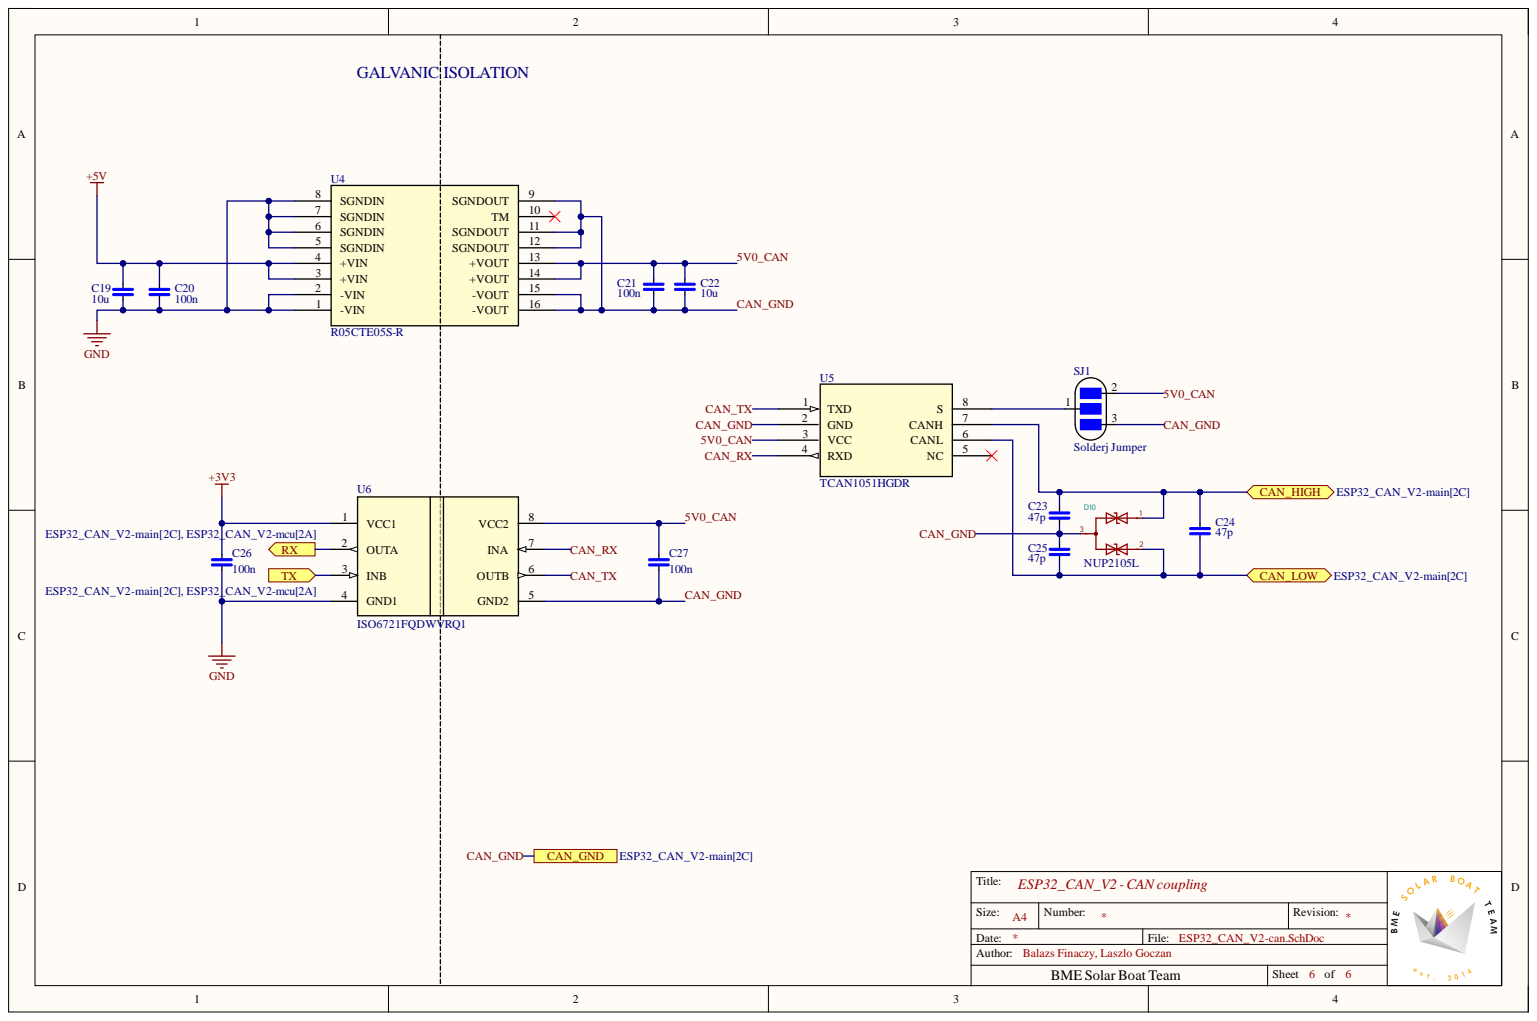
[picture p33: page 6]

Title: ESP32_CAN_V2 - CAN coupling

Size: A4 | Number: * | Revision: *

Date: * | File: ESP32_CAN_V2-can.SchDoc

Balazs Finaczy, Laszlo Goczan
BME Solar Boat Team

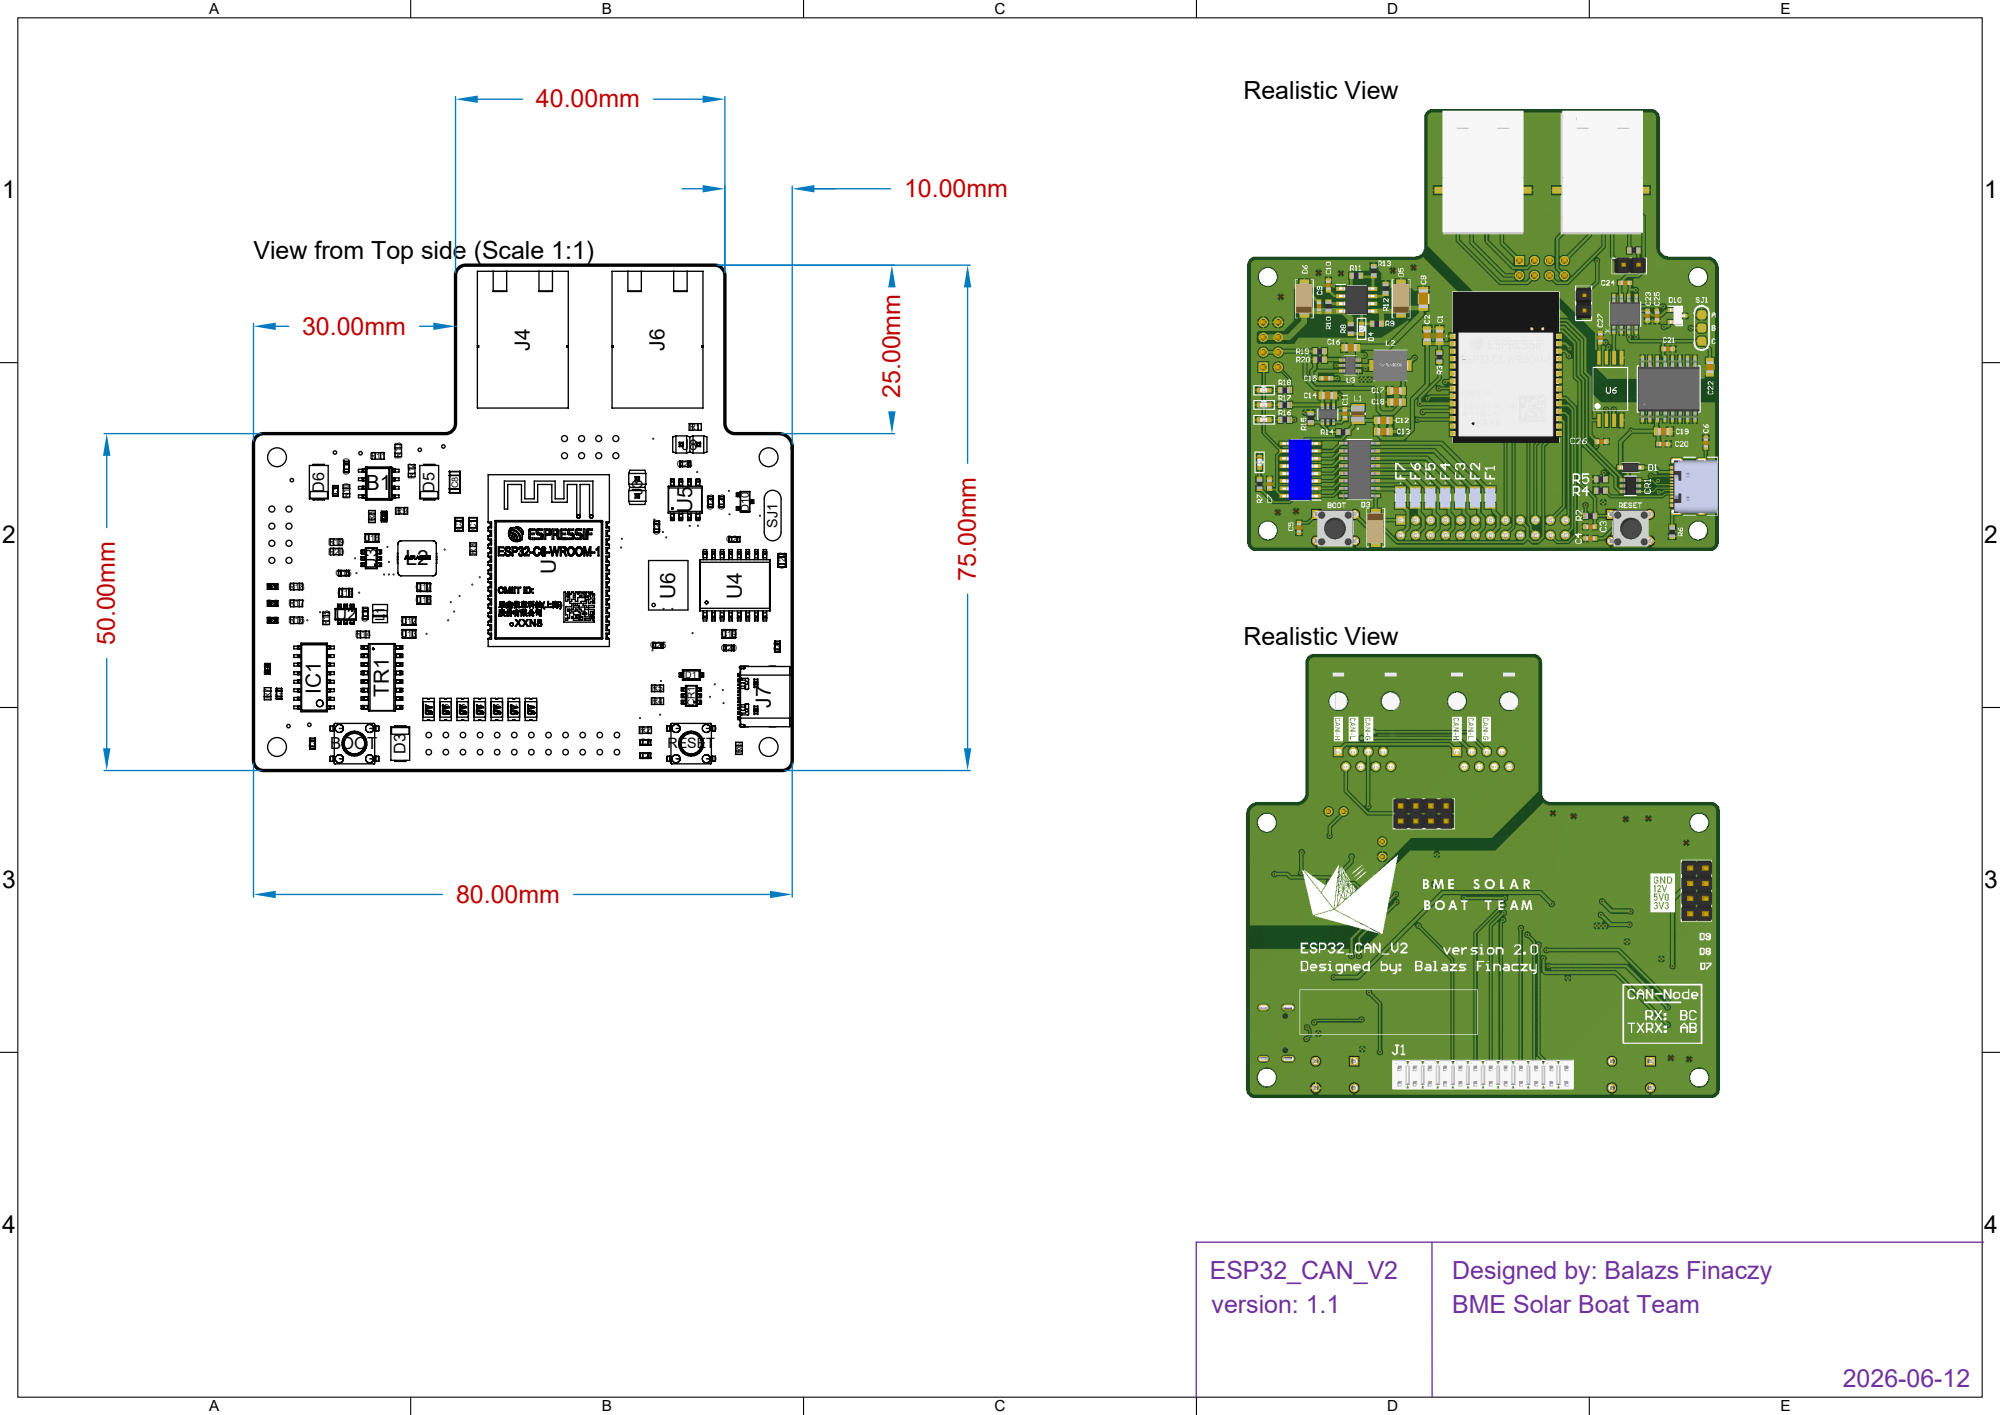
[picture p34: page 7]

View from Top side (Scale 1:1)

Designed by: Balazs Finaczy
BME Solar Boat Team
