BME-SBT/ESP32_CAN_V2/documentation/content/images/Job1.PDF

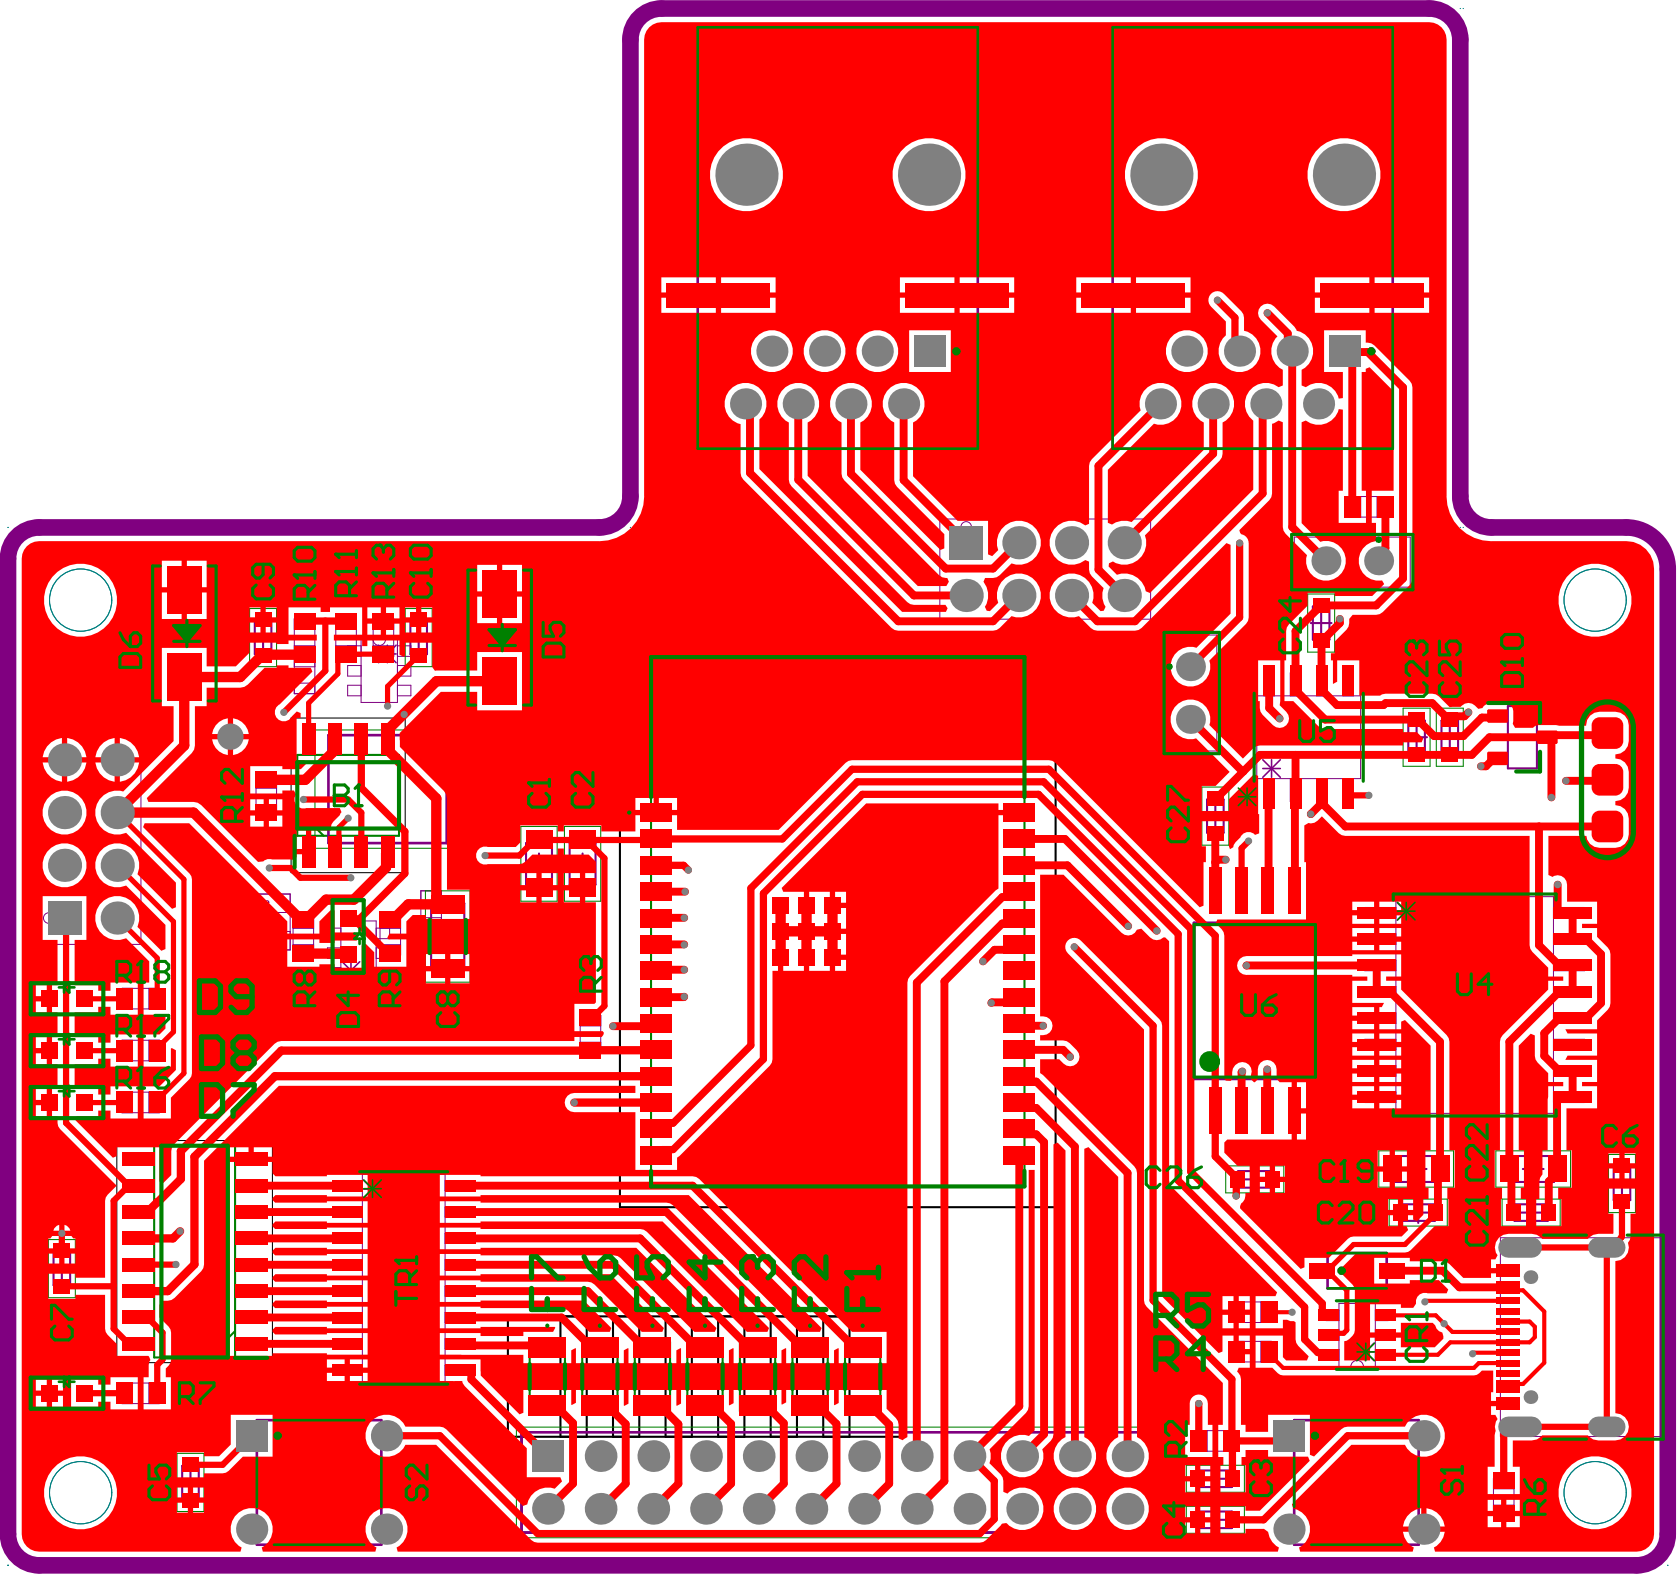
[picture p35: page 1]

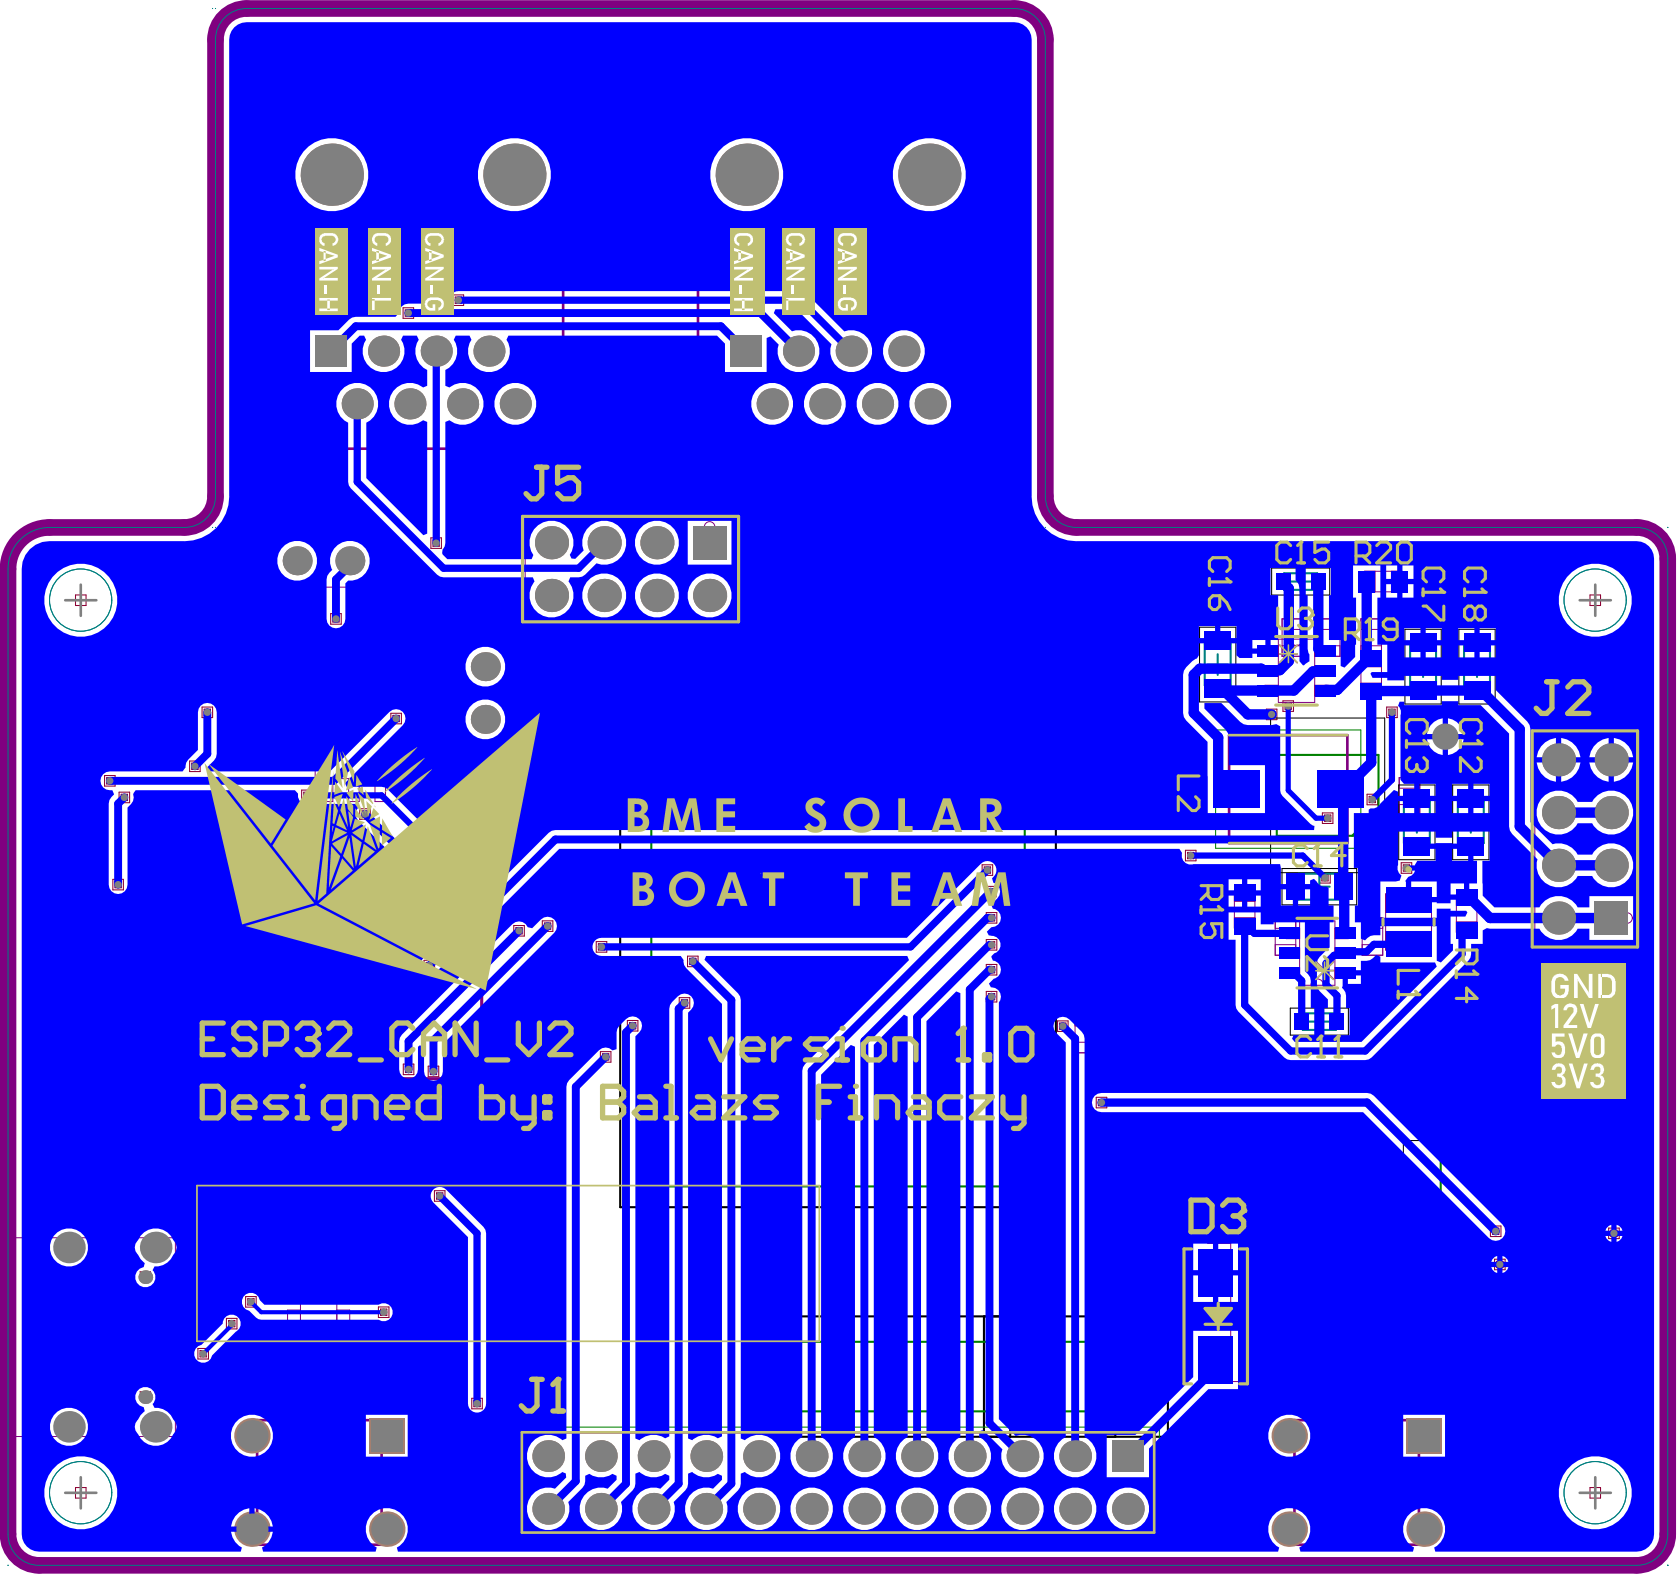
[picture p36: page 2]
