BME-SBT/ESP32_CAN_V2/(list of files, drawings)

Other design files:
hardware/ESP32_CAN_V2-can.SchDoc
hardware/ESP32_CAN_V2-main.SchDoc
hardware/ESP32_CAN_V2-mcu.SchDoc
hardware/ESP32_CAN_V2-out.SchDoc
hardware/ESP32_CAN_V2-power.SchDoc
hardware/ESP32_CAN_V2-usb.SchDoc
hardware/ESP32_CAN_V2.2.PcbDoc
hardware/ESP32_CAN_V2.PcbDoc
hardware/ESP32_CAN_V2.PcbLib
hardware/ESP32_CAN_V2.PrjPcb
hardware/ESP32_CAN_V2.SchLib
