BME-SBT/ESP32_CAN_V2/hardware/Out/sizes.ini

[Page0.emf]
Pixel_PrintingWidth=6900
Pixel_PrintingHeight=4560
Mils_PrintingHeight=7600
Mils_PrintingWidth=11500
[Page1.emf]
Pixel_PrintingWidth=6900
Pixel_PrintingHeight=4560
Mils_PrintingHeight=7600
Mils_PrintingWidth=11500
[Page2.emf]
Pixel_PrintingWidth=6900
Pixel_PrintingHeight=4560
Mils_PrintingHeight=7600
Mils_PrintingWidth=11500
[Page3.emf]
Pixel_PrintingWidth=6900
Pixel_PrintingHeight=4560
Mils_PrintingHeight=7600
Mils_PrintingWidth=11500
[Page4.emf]
Pixel_PrintingWidth=6900
Pixel_PrintingHeight=4560
Mils_PrintingHeight=7600
Mils_PrintingWidth=11500
[Page5.emf]
Pixel_PrintingWidth=6900
Pixel_PrintingHeight=4560
Mils_PrintingHeight=7600
Mils_PrintingWidth=11500
