BME-SBT/ESP32_CAN_V2/(commit log)

2026-04-06 Project added to version control.
    [10129381-906003BLF--3DModel-STEP-533217.STEP, 10129381-906003BLF.SchLib, 10129381-908002BLF.PcbLib, 10129381-908002BLF.SchLib, 10129381-924003BLF--3DModel-STEP-533217.STEP, 10129381-924003BLF.SchLib, 150060BS83000.stp, 1N5819HW-7-F.STEP]
2026-04-06 Components library removed.
    [10129381-906003BLF--3DModel-STEP-533217.STEP, 10129381-906003BLF.SchLib, 10129381-908002BLF.PcbLib, 10129381-908002BLF.SchLib, 10129381-924003BLF--3DModel-STEP-533217.STEP, 10129381-924003BLF.SchLib, 150060BS83000.stp, 1N5819HW-7-F.STEP]
2026-04-06 Redundant pinheader (J3) removed.
    [ESP32_CAN_V2-main.SchDoc, ESP32_CAN_V2.PcbDoc, old_ESP32_CAN_V2.PcbDoc]
2026-04-06 Polygon pours were created.
    [ESP32_CAN_V2.PcbDoc]
2026-04-06 USB connector had been wired.
    [ESP32_CAN_V2.PcbDoc]
2026-04-06 IC1 and TR1 connections rewired.
    [ESP32_CAN_V2-out.SchDoc]
2026-04-06 SMASERIES_LTF -> pads enlarged
    [ESP32_CAN_V2.PcbLib]
2026-04-06 Intersheet connector '+5' unified and renamed on each page to '+5V'.
    [ESP32_CAN_V2-can.SchDoc, ESP32_CAN_V2-power.SchDoc, ESP32_CAN_V2.PcbDoc, ESP32_CAN_V2.PrjPcb]
2026-04-06 '+5' connector renamed to '+5V'
    [ESP32_CAN_V2-can.SchDoc]
2026-04-19 Intersheet port names unified.
    [ESP32_CAN_V2-power.SchDoc]
2026-04-19 Board outline had been redrawn.
    [ESP32_CAN_V2.1.PcbDoc]
2026-04-19 Importable board outline.
    [board_outline_v2.dxf]
2026-04-19 Old version.
    [ESP32_CAN_V2.PcbDoc]
2026-04-19 Some components were recentered.
    [ESP32_CAN_V2.PcbLib]
2026-04-22 L1 properly connected to net.
    [ESP32_CAN_V2-power.SchDoc]
2026-04-22 Supply section designed.
    [ESP32_CAN_V2.1.PcbDoc]
2026-04-22 Footprint of L1 had been updated.
    [ESP32_CAN_V2.PcbLib]
2026-04-22 Placeing was completed.
    [ESP32_CAN_V2.1.PcbDoc]
2026-05-03 PCB design had been finished
    [ESP32_CAN_V2-can.SchDoc, ESP32_CAN_V2-main.SchDoc, ESP32_CAN_V2-mcu.SchDoc, ESP32_CAN_V2.1.PcbDoc, ESP32_CAN_V2.PrjPcb]
2026-06-11 New version had been created.
    [ESP32_CAN_V2.2.PcbDoc]
2026-06-11 Schematic had been corrected at the DCDC coupler.
    [ESP32_CAN_V2-can.SchDoc]
2026-06-11 Updated with new records.
    [ESP32_CAN_V2.1.PcbDoc]
2026-06-11 Footprint of USB-C connector had been corrected.
    [ESP32_CAN_V2.PcbLib]
2026-06-11 Value of R10 had been corrected.
    [ESP32_CAN_V2-power.SchDoc]
2026-06-11 Power supply had been edited.
    [ESP32_CAN_V2.2.PcbDoc]
2026-06-11 Some changes were made.
    [ESP32_CAN_V2.2.PcbDoc, ESP32_CAN_V2.PrjPcb]
2026-06-12 Power supplay and darlington are tracked.
    [ESP32_CAN_V2.2.PcbDoc]
2026-06-12 Routing had been finished.
    [ESP32_CAN_V2.2.PcbDoc]
2026-06-12 Footrpint of USB-C had been corrected.
    [ESP32_CAN_V2.PcbLib]
2026-06-12 Silkscreen had been rearranged.
    [ESP32_CAN_V2.2.PcbDoc]
2026-06-12 Gerber had been added.
    [ESP32_CAN_V2.2.GBL, ESP32_CAN_V2.2.GBO, ESP32_CAN_V2.2.GBP, ESP32_CAN_V2.2.GBS, ESP32_CAN_V2.2.GTL, ESP32_CAN_V2.2.GTO, ESP32_CAN_V2.2.GTP, ESP32_CAN_V2.2.GTS]
2026-06-12 Design had been corrected.
    [ESP32_CAN_V2.2.PcbDoc]
2026-06-12 Values of resistors had been corrected.
    [ESP32_CAN_V2-power.SchDoc]
2026-06-12 Power plane had been isolated.
    [ESP32_CAN_V2.2.PcbDoc]
2026-06-12 Outputjob for exporting normal gerbers.
2026-06-12 Powerplane had been isolated.
    [ESP32_CAN_V2.PrjPcb]
2026-06-12 Unrouted net constraint had been resolved.
    [ESP32_CAN_V2-main.SchDoc, ESP32_CAN_V2.2.PcbDoc]
2026-06-12 Last edits were made before ordering the pcb.
    [ESP32_CAN_V2.2.PcbDoc, ESP32_CAN_V2.PrjPcb]
2026-06-18 Some values were updated.
    [ESP32_CAN_V2-can.SchDoc, ESP32_CAN_V2-main.SchDoc, ESP32_CAN_V2-mcu.SchDoc, ESP32_CAN_V2-out.SchDoc, ESP32_CAN_V2-power.SchDoc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]
