BME-SBT/ESP32_CAN_V2/documentation/ppt/IMG_1610.JPG

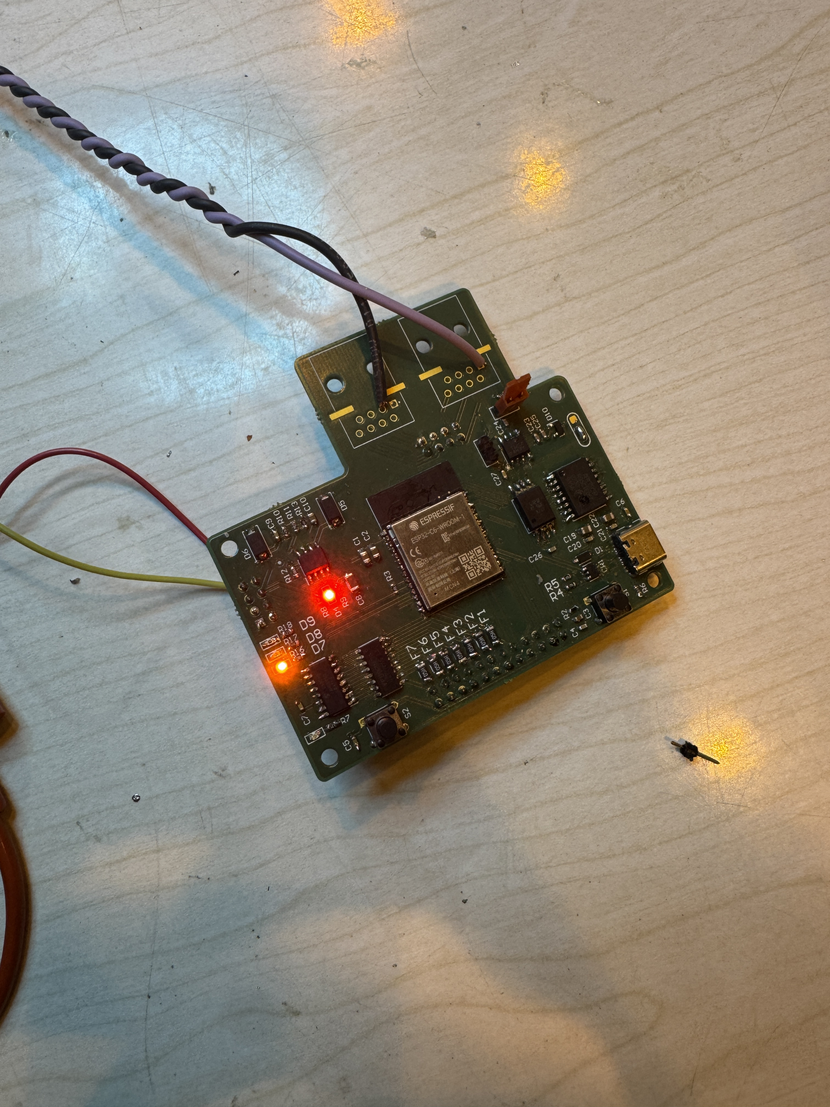
documentation/ppt/IMG_1610.JPG
